opsec-bot/Reactivity/PROGRESS.md

# PROGRESS

Running log of what's done and what's known. Newest entries on top.

## On-board Lua scripts ✅ (2026-09-24)

New **Scripts** tab: write Lua in the app, "Run on board" uploads it to the Pico, which runs
it on its **second core** (core 1) with the same API as Logitech G Hub scripts
(`OnEvent`, `MoveMouseRelative`, `PressMouseButton`, `IsMouseButtonPressed`, `Sleep`,
`OutputLogMessage`, ...), so G Hub scripts paste in. Extension: `SetMouseButtonBlocked(n, on)`
hides a physical button from the PC. "Save to board" stores it in flash and it autostarts at
boot, so it works with the app closed.

- Firmware: Lua 5.4.8 vendored in `firmware/pico_device/src/lua/` (no io/os/package/debug,
  32-bit numbers, C recursion capped at 64). `script_engine.cpp` owns the VM: 24 KB private
  stack, 96 KB heap cap, pico-sdk queues to/from core 0 (button edges in; actions and log
  out). Core 0's hot path only gains one queue push per button edge.
- Stop is immediate even for `while true do end` or a loop wrapped in `pcall` (count hook +
  Sleep checks). A stopped or crashed script always releases any button it held.
- **Flash layout changed**: FQBN is now `flash=2097152_65536` (64 KB LittleFS for the
  script). The first boot after that formats the FS (~1 s). Saving briefly stalls
  passthrough (flash writes run with interrupts off).
- CDC: `script_begin/chunk/end` (base64, 150 B per line), `script_run/stop/save/erase/status`;
  the board replies `script_status`, `script_log`, and the 1 Hz status gained `"script"`.

Verified on hardware (Pico on COM7, 14 checks over the serial protocol): print/format,
PROFILE_ACTIVATED, syntax/runtime errors reported, busy loop + pcall-wrapped loop + Sleep
loop all stop, PROFILE_DEACTIVATED runs, heap cap -> "not enough memory" (board survives),
200-deep nesting rejected (no stack crash), unsupported-API message, a script moved the real
cursor 100 px left, oversize upload rejected, save/erase. `cargo check`, `tsc`, `vite build`.
NOT yet verified: button-triggered events from the physical mouse (needs someone pressing
buttons), autostart after a power cycle, and the Scripts tab in the running Tauri window.

---

## Firmware tab in the Control app ✅ (2026-09-24)

New **Firmware** tab: detects the boards, "Build & flash all" or per board, per-step
progress (build / flash / verify with timings), live output, actionable failure hints, and
an automatic serial disconnect before / reconnect after. Backend: `src-tauri/src/flash.rs`
runs `scripts/flash.py --json` on a std thread and forwards each line as a `flash://event`
(one run at a time; `exit` is always the last event). `serial::disconnect_blocking` joins the
reader thread so the COM port is really closed before flashing (the old `disconnect` only
queued a message). Frontend: `useFlasher` hook (lives in `App`, so a run keeps updating
while you look at another tab) + `FirmwarePanel`.

Verified: `cargo test` (7 unit + 1 real round trip through Python/arduino-cli, run with
`--include-ignored`), `tsc` strict + `vite build`, and the real frontend in a browser against
a mock backend replaying the script's event format: ok run, failed step with hint, backend
cannot start Python, nothing plugged in, per-board `--only`, switching tabs mid-run, and
disconnect -> flash -> reconnect. NOT yet verified: a real flash triggered from the running
Tauri window (the app must be restarted to pick up the new code: `pnpm tauri dev`).

---

## Flash tool ✅ (2026-09-24)

`scripts/flash.py` detects which boards are plugged in (via `arduino-cli board list`
JSON: CP210x `10C4:EA60` = ESP32, `046D:C547`/`239A:CAFE`/`2E8A:*` serial or a UF2
drive = Pico), builds the matching sketch and flashes it; a Pico already running this
firmware is rebooted into its bootloader by the 1200-baud touch, then checked to
re-enumerate as `046D:C547`. Missing boards are skipped, ambiguous ones need `--esp-port`
/ `--pico-port`. `--json` emits events for a future GUI button. 15 offline tests in
`scripts/test_flash.py`.

Tried on the real setup: `--check`, `--json`, `--build-only`, and a full run that flashed
both boards (Pico via the running-firmware path, 9.7 s, verified back on COM7). Not tried:
Pico-in-BOOTSEL and unplugged-board paths (unit-tested only). Builds are ~20-30 s each
normally; they took minutes while a game was hogging the CPU.

---

## Phase 5 — Low-latency pipeline ✅ 1 kHz feed verified on hardware (2026-09-24)

Flashed to the real boards and measured (results at the bottom). End-to-end latency is
still unmeasured. Originals are kept next to the sketches as `*.ino.orig` (this folder
is not a git repo).

### What was wrong
- **ESP32 host was the bottleneck.** `EspUsbHost::task()` was called from `loop()`.
  It blocks 1 tick in `usb_host_lib_handle_events()` and 1 tick in
  `usb_host_client_handle_events()` on every pass (tick = 1 ms here), and re-submits
  the IN transfer only on a `millis()` timer (`(now-last) > interval`, i.e. every
  >= 2 ms). Net: the dongle was polled at a few hundred Hz, not 1 kHz, and each
  report waited up to a tick before its callback ran. (Matches the Phase 2 log:
  0 -> 554 frames in ~2 s.) The old "sub-2 ms by construction" estimate did not hold.
- **Pico dropped motion.** `handleFrame` sent only `if (usb_hid.ready())`, otherwise
  the report was discarded. The dongle's 1 ms clock and the USB frame clock drift, so
  the endpoint is regularly busy at the wrong moment. Injected `move`/`click` had the
  same drop, and an injected click clobbered held physical buttons (and vice versa).
- CDC writes (ack/status/error) were unguarded; `Adafruit_USBD_CDC::write()` spins while
  its FIFO is full, so a GUI that stops reading could stall passthrough. The watch
  stream also ran `snprintf` per frame on the hot path. UART RX FIFO was 32 bytes.

### What changed
- **ESP32:** dedicated `usbClientTask` (prio 20) blocks in
  `usb_host_client_handle_events()` and wakes on completion; `onReceive()` copies the
  report, **re-arms the transfer immediately**, then remaps + forwards. **Three URBs are
  kept queued** on EP 0x81 (`MOUSE_URB_DEPTH`): re-arming a single URB was not enough
  (see Measured). Only the mouse endpoint is armed. `usbLibTask` handles enumeration.
  `loop()` is cold path only. TX ring buffer so `Serial1.write()` doesn't wait for the wire.
- **Pico:** coalescing report queue (fold same-button reports, keep press/release edges
  ordered, never drop motion, chunk to int16/int8); physical|injected buttons merged;
  hot path (UART -> queue -> USB) has no formatting/CDC/LED work; guarded CDC writes;
  256-byte UART FIFO; drop instead of accumulating while the host is not mounted.
- **Status line** gained `rx_hz, tx_hz, lat_avg_us, lat_max_us, merged, q_hwm`
  (additive; the app ignores unknown keys). ESP heartbeat now prints frames/s.

### Measured (Pico status line, continuous mouse motion, Superlight @ 1 kHz)
| ESP32 build | UART frames/s into the Pico (`rx_hz`) |
|---|---|
| Phase 2/4 (`task()` in `loop()`) | not measured; log implies ~280/s ("0 -> 554 in ~2 s") |
| Phase 5, one URB re-armed in the callback | 466 - 517 |
| Phase 5, **three URBs queued** (current) | **941 - 997, mean 958** (15 samples) |

So the mouse was reporting at 1 kHz all along; the ceiling was on our side. (Re-arming
fast was not the fix; queueing several URBs was. The *why* — a poll slot going empty
during resubmit — is inferred, the numbers are measured.)

- `frames_bad = 0` across ~140k frames: the UART link is clean.
- Pico residency (UART frame in -> USB send): **13 us average**, typically 20-36 us max.
  One report arrived while the IN endpoint was busy and was folded into the next one
  (`merged`, 1033 us residency) — the old firmware would have dropped it.
- Injected `move` acked and sent as its own USB report; remap round trip PC -> Pico ->
  reverse UART -> ESP works (table `0 1 2 4 4`, restored to identity).
- Queue/inject logic also run unmodified on the host against a fake endpoint: motion
  conserved exactly (200k-frame soak, overflow, chunking), button edges stay ordered,
  injected clicks OR with physical buttons and release independently.

### Not verified yet
- **End-to-end latency** (dongle report in -> PC sees it). `lat_*_us` is Pico-only.
- Injected **click/scroll** on hardware (host-tested only), dongle unplug/replug
  (reconnect path), and a long soak.
- Arming only EP 0x81 worked on this dongle; if another receiver stays silent, that is
  the first thing to suspect.

---

## Phase 4 — Pico USB identity ✅ (2026-06-07)

The Pico now presents to the PC as a generic **"Logitech USB Receiver"
(046D:C547)** — the same identity the real Superlight dongle would show — instead
of the TinyUSB default `239A:CAFE`. (Generic Logitech ID, allowed per §11.3; no
cheat-device IDs.)

- `pico_device.ino` setup(): `TinyUSBDevice.setManufacturerDescriptor("Logitech")`,
  `setProductDescriptor("USB Receiver")`, `setID(0x046D, 0xC547)`, then
  `detach()/attach()` to force re-enumeration (arduino-pico inits USB before
  setup()). Verified: `board list` shows the CDC as **046D:C547**.
- The HID report descriptor is unchanged, so passthrough/remap behave identically.
- **COM renumbers on identity change** (new VID/PID = new device to Windows):
  the Pico's CDC moved COM14 -> **COM15**. The app's `is_pico` now matches both
  the old (239A:CAFE) and new (046D:C547) IDs, so auto-select still works.

### Remaining Phase 4 (optional polish)
- README usage section; tag a release (e.g. v0.1.0).
- (Stretch) keyboard-HID on the Pico to enable keystroke remaps (ctrl+c etc.).

---

## Phase 3b — Button remap (ESP32 intercept) + DTR fix (2026-06-07)

### DTR fix — the watch/status "doesn't work" bug
Symptom: app Connected + Control worked, but Status tiles + Watch stayed empty
(Console showed only outgoing `->` lines, zero incoming `<-`).
Root cause: **Adafruit TinyUSB CDC gates device->host writes on DTR**
(`tud_cdc_connected()`); `serialport-rs` leaves DTR low on open, so the Pico
silently dropped every status/evt/ack line. (pyserial asserts DTR by default —
why the earlier Python test worked.) Fix: `serial.rs` asserts
`write_data_terminal_ready(true)` (+ RTS) right after open.

### Remap (button -> button intercept)
- Flow: app -> Pico (CDC) -> Pico forwards §9 `type=0x02` JSON frame on its
  reverse UART (GP0 TX) -> ESP32 stores the rule and **rewrites the buttons
  bitfield at the source** in `onReceive` (`applyRemap`). Identity by default.
- Scope: button->button and "none" (disable). Keystroke actions (ctrl+c) need a
  keyboard HID on the Pico — deferred.
- **New wire required:** Pico **GP0** (pin 1, UART0 TX) -> ESP32 **GPIO48**.
  (GND already shared; GPIO48 is free on the v1.1 DevKitC — RGB LED is on GPIO38.)
- ESP firmware: reverse-UART frame parser (`rfeed`) + `handleEspCmd` +
  `g_remap[5]` table; compiles 23%, flashed to COM7.

---

## Phase 3a — Tauri control app + Pico CDC protocol ✅ WORKING (2026-06-07)

A **Tauri v2 desktop app** ("Superlight Control", React + Tailwind v4 + shadcn)
drives the Pico over its USB-CDC serial port with the §9 JSON-line protocol.
Built and verified; `remap` (the cross-board bit) is deferred to **Phase 3b**.

### Stack
- `rust-client/` — Tauri v2. Frontend Vite + React 19 + TS + Tailwind v4 +
  shadcn/ui (slate, dark). Backend Rust: blocking `serialport` on a dedicated
  `std::thread` (NO async/tokio in our code, §11.6) bridging CDC lines to Tauri
  events (`serial://line`, `serial://status`).
- Pico firmware gained a CDC command layer (dependency-free JSON parse).

### Protocol (PC <-> Pico, JSON lines)
- PC->Pico: `move{dx,dy}` `click{btn}` `scroll{wheel}` `status` `watch{on}`
  `remap{from,to}`.
- Pico->PC: `{"type":"ack","what":..}`, `{"type":"status",uptime_ms,esp_alive,
  frames_ok,frames_bad,watching}` (1 Hz heartbeat, replaced the old plaintext),
  `{"type":"evt","kind":"mouse",buttons,dx,dy,wheel}` while watching.

### Verified
- Tauri app compiles: frontend (`pnpm build`, 1873 modules) + backend
  (`cargo check`, serialport 4.9).
- Pico reflashed; bidirectional test passed: `status`/`move`/`click`/`watch`
  all ack, status streams at 1 Hz, `watching` flips true.
- **Hot-path safety:** the `watch` stream only writes when
  `Serial.availableForWrite()` has room for the whole line — it drops events
  rather than blocking passthrough (protects the latency budget).

### Phase 3 acceptance (HANDOFF §10)
- [x] `rust-client/` compiles cleanly
- [x] move / click / scroll commands → HID injected on the Pico
- [x] watch → live event stream
- [ ] `remap` configures a rule on the ESP32 — **Phase 3b** (needs reverse-UART
      Pico GP0→ESP IO48 wired + ESP-side handler; the app/firmware already send
      the §9 type=0x02 frame, the ESP just ignores it for now)

### Remaining
- Phase 3b: wire reverse UART, ESP32 remap handler + type=0x03 reply relay.
- Carry-over from Phase 2: all-5-buttons/scroll confirm + latency measurement.

---

## Phase 2 — End-to-end pass-through ✅ WORKING (2026-06-07)

**Moving the Superlight moves the PC cursor through the full chain**, confirmed
on hardware:

```
Superlight ~RF~ Lightspeed dongle --USB host--> DevKitC-1 --UART 1Mbaud--> Pico H --USB HID--> PC
```

### Host board pivot: OTG board → DevKitC-1
- Phase 1 reverse-engineering was done on the **ESP32-S3-USB-OTG** board (dongle
  plugs straight into its USB_HOST port). That board is now **retired**.
- Phase 2 needs a UART wire from the host to the Pico (GPIO47 → GP1). The OTG
  board's free pins (GPIO47/48) are **bare solder pads** — no way to attach a
  jumper without a soldering iron (not on hand). So the host moved to the
  **ESP32-S3-DevKitC-1-N32R16V**, which has pre-soldered headers.
- The dongle now reaches the DevKitC's **native USB host** (GPIO19/20) via a
  **USB-A female breakout** wired to the headers. See `docs/esp32-s3-n32r16v.md`.

### What's verified
- DevKitC boots cleanly with `FlashMode=opi` (WROOM-2 Octal flash) — boot log
  shows `Octal Flash Mode Enabled`. Full FQBN in `docs/esp32-s3-n32r16v.md`.
- **Stage A:** dongle enumerates on native USB host; `frames sent` climbs on
  motion (e.g. 0 → 554 in ~2 s). USB-over-jumpers is electrically fine, no drops.
- **Stage B:** UART link GPIO47→GP1 (+ shared GND). Pico reports
  **`frames ok=N bad=0`** — zero CRC errors across thousands of frames = clean
  link, good ground. Pico HID `usb=ready` (mounted on PC).
- **Cursor moves** when the Superlight moves. ✅

### Gotcha worth remembering
- Opening **COM7** (the DevKitC `UART` port) asserts DTR/RTS and **auto-resets
  the ESP32**, briefly halting the stream. Watch the **Pico (COM14)** during live
  runs — it doesn't reset the chain. (Same DTR auto-reset that makes flashing work.)

### Remaining for Phase 2 sign-off
- Confirm all **5 buttons + scroll** pass through (movement confirmed).
- **Measure added latency** (target ≤2 ms, ≤5 ms hard cap).

---

## Phase 1 — Dongle decode ✅ COMPLETE

### Done
- Project scaffold created; git initialized.
- Toolchain verified (`arduino-cli` 1.5.1, esp32 core 3.0.0, EspUsbHost 1.0.1,
  pyserial 3.5, Rust/cargo present).
- COM-port map identified (see `docs/notes.md`).
- Dumper firmware compiles + uploads from CLI (no IDE GUI).
- Dongle enumerates on USB_HOST; descriptors captured to
  `captures/dongle-descriptors.log`.
- 1592 mouse reports captured to `captures/dongle-reports.log` covering all 5
  buttons + X/Y + wheel.
- `scripts/decode_reports.py` parses the capture and prints decoded events;
  verified L/R/M/back/fwd + wheel±1 + signed dx/dy all correct.

### Findings — THIS dongle (Logitech Lightspeed receiver)
- **VID:PID = `046D:C547`** ("Logitech USB Receiver"). bcdDevice 0x0204, bus
  powered, bMaxPower 98 mA. (Note: C547 is one of the IDs the brief greenlit for
  Phase 4 cloning — handy.)
- **3 HID interfaces, all bInterval=1 (1000 Hz):**
  | IF | EP | Role | Report-desc len |
  |---|---|---|---|
  | 0 | 0x81 | Mouse | 83 B |
  | 1 | 0x82 | Keyboard + Consumer + System | 133 B |
  | 2 | 0x83 | Logitech HID++ vendor (FF00) | 54 B |
- **Mouse report = 13 bytes, NO report ID** (endpoint 0x81):

  | byte | field | type |
  |---|---|---|
  | 0 | buttons 1–8 (bit0=L, bit1=R, bit2=M, bit3=back, bit4=fwd) | u8 bitfield |
  | 1 | buttons 9–16 (unused on Superlight, always 0) | u8 |
  | 2–3 | dX | **int16 LE** |
  | 4–5 | dY | **int16 LE** |
  | 6 | wheel | int8 |
  | 7 | hwheel / AC Pan | int8 |
  | 8–12 | vendor padding | 5×u8 |

- **Quirks / gotchas:**
  - The keyboard interface (EP 0x82) streams idle reports `01 00 00 …` (17 B,
    report ID 1) even when nothing is pressed — these are NOT mouse data. Filter
    by endpoint (mouse = 0x81).
  - **Build flag:** use `USBMode=default` on the `esp32s3usbotg` FQBN, NOT
    `hwcdc`. `hwcdc` sets cdc_on_boot=1 → `Serial` lands on the native USB CDC,
    which we reroute to the host port (invisible). `default` → `Serial` = UART0 →
    CP210x → COM12. (HANDOFF §5 advice was for the generic Dev Module.)
  - **DebugLevel=info** is required for EspUsbHost to print descriptors
    (`_printPcapText` is `#if ARDUHAL_LOG_LEVEL >= INFO`). Per-report flooding is
    gated at VERBOSE, so `info` is the right level: descriptors yes, flood no.
  - 16-bit X/Y means high-speed flicks won't clip at ±127 — maps cleanly onto the
    §9 UART payload `{buttons, dx:i16, dy:i16, wheel:i8, hwheel:i8}`.

### Next (Phase 2)
- ESP32: parse EP 0x81 reports natively in `onReceive`, frame per §9, send over
  UART (GPIO45/46 plan) at 1 Mbaud.
- Pico: TinyUSB HID mouse; receive UART frames, replay to PC.
- Measure latency (target ≤2 ms added, ≤5 ms hard cap).
