opsec-bot/Reactivity/docs/Pi-Pico-H-DOCS.md

Accept optional cookies Reject optional cookies

[Raspberry Pi](https://www.raspberrypi.com/)

*   [For industry](https://www.raspberrypi.com/for-industry/)
*   [For home](https://www.raspberrypi.com/for-home/)

*   [Hardware](https://www.raspberrypi.com/products/)
*   [Software](https://www.raspberrypi.com/software/)
*   [Documentation](https://www.raspberrypi.com/documentation/)
*   [News](https://www.raspberrypi.com/news/)
*   [Forums](https://forums.raspberrypi.com/)
*   [Foundation](https://www.raspberrypi.org)
*   [Contact](https://www.raspberrypi.com/contact/)

[Documentation](/documentation)
-------------------------------

*   [](/documentation/computers/)
    
    Computers

*   [](/documentation/computers/getting-started.html)
    
    Getting started

*   [
    
    Hardware prerequisites
    
    ](/documentation/computers/getting-started.html#hardware-prerequisites)

*   [
    
    Networking
    
    ](/documentation/computers/getting-started.html#networking)

*   [
    
    Set up your Raspberry Pi
    
    ](/documentation/computers/getting-started.html#setup)

*   [
    
    Install an OS onto boot media
    
    ](/documentation/computers/getting-started.html#install)

*   [
    
    Configuration
    
    ](/documentation/computers/getting-started.html#configuration)

*   [
    
    Shutdown options
    
    ](/documentation/computers/getting-started.html#shutdown)

*   [
    
    Troubleshooting
    
    ](/documentation/computers/getting-started.html#troubleshooting)

*   [
    
    Next steps
    
    ](/documentation/computers/getting-started.html#next)

*   [](/documentation/computers/os.html)
    
    Raspberry Pi OS

*   [
    
    OS installation
    
    ](/documentation/computers/os.html#os-installation)

*   [
    
    Manage software and firmware updates
    
    ](/documentation/computers/os.html#manage-software-and-firmware-updates)

*   [
    
    Play audio and video
    
    ](/documentation/computers/os.html#play-audio-and-video)

*   [
    
    Utilities
    
    ](/documentation/computers/os.html#utilities)

*   [
    
    Accessibility options
    
    ](/documentation/computers/os.html#accessibility-options)

*   [
    
    Use Python on a Raspberry Pi
    
    ](/documentation/computers/os.html#use-python-on-a-raspberry-pi)

*   [
    
    Use GPIO from Python
    
    ](/documentation/computers/os.html#use-gpio-from-python)

*   [](/documentation/computers/configuration.html)
    
    Configuration

*   [
    
    Configuration methods
    
    ](/documentation/computers/configuration.html#config-methods)

*   [
    
    Audio and visual output
    
    ](/documentation/computers/configuration.html#audio-and-visual-output)

*   [
    
    Networking
    
    ](/documentation/computers/configuration.html#networking)

*   [
    
    Wireless connection
    
    ](/documentation/computers/configuration.html#wireless-connection)

*   [
    
    System and localisation
    
    ](/documentation/computers/configuration.html#system-and-localisation)

*   [
    
    User access and management
    
    ](/documentation/computers/configuration.html#users)

*   [
    
    Remote access
    
    ](/documentation/computers/configuration.html#remote)

*   [
    
    Hardware communication
    
    ](/documentation/computers/configuration.html#hardware-communication)

*   [
    
    Performance
    
    ](/documentation/computers/configuration.html#performance)

*   [
    
    LED behaviour
    
    ](/documentation/computers/configuration.html#led-behaviour)

*   [
    
    Boot behaviour
    
    ](/documentation/computers/configuration.html#boot-behaviour)

*   [
    
    Firmware
    
    ](/documentation/computers/configuration.html#firmware)

*   [
    
    External storage
    
    ](/documentation/computers/configuration.html#external-storage)

*   [
    
    Operational security
    
    ](/documentation/computers/configuration.html#operational-security)

*   [
    
    Further reference
    
    ](/documentation/computers/configuration.html#further-reference)

*   [](/documentation/computers/config_txt.html)
    
    `config.txt`

*   [
    
    What is `config.txt`?
    
    ](/documentation/computers/config_txt.html#what-is-config-txt)

*   [
    
    `autoboot.txt`
    
    ](/documentation/computers/config_txt.html#autoboot-txt)

*   [
    
    Common options
    
    ](/documentation/computers/config_txt.html#common-options)

*   [
    
    Onboard analogue audio (3.5 mm jack)
    
    ](/documentation/computers/config_txt.html#onboard-analogue-audio-3-5-mm-jack)

*   [
    
    HDMI audio
    
    ](/documentation/computers/config_txt.html#hdmi-audio)

*   [
    
    Boot Options
    
    ](/documentation/computers/config_txt.html#boot-options)

*   [
    
    GPIO control
    
    ](/documentation/computers/config_txt.html#gpio-control)

*   [
    
    Overclocking options
    
    ](/documentation/computers/config_txt.html#overclocking-options)

*   [
    
    Conditional filters
    
    ](/documentation/computers/config_txt.html#conditional-filters)

*   [
    
    Memory options
    
    ](/documentation/computers/config_txt.html#memory-options)

*   [
    
    Licence key and codec options
    
    ](/documentation/computers/config_txt.html#licence-key-and-codec-options)

*   [
    
    Video options
    
    ](/documentation/computers/config_txt.html#video-options)

*   [
    
    Camera settings
    
    ](/documentation/computers/config_txt.html#camera-settings)

*   [](/documentation/computers/linux_kernel.html)
    
    The Linux kernel

*   [
    
    Introduction
    
    ](/documentation/computers/linux_kernel.html#kernel)

*   [
    
    Update
    
    ](/documentation/computers/linux_kernel.html#update)

*   [
    
    Build the kernel
    
    ](/documentation/computers/linux_kernel.html#building)

*   [
    
    Configure the kernel
    
    ](/documentation/computers/linux_kernel.html#configure-the-kernel)

*   [
    
    Patch the kernel
    
    ](/documentation/computers/linux_kernel.html#patch-the-kernel)

*   [
    
    Kernel headers
    
    ](/documentation/computers/linux_kernel.html#kernel-headers)

*   [
    
    Contribute
    
    ](/documentation/computers/linux_kernel.html#contribute)

*   [](/documentation/computers/remote-access.html)
    
    Remote access

*   [
    
    Introduction to remote access
    
    ](/documentation/computers/remote-access.html#introduction-to-remote-access)

*   [
    
    Find the IP address of your Raspberry Pi
    
    ](/documentation/computers/remote-access.html#ip-address)

*   [
    
    Access a remote terminal with SSH
    
    ](/documentation/computers/remote-access.html#ssh)

*   [
    
    Screen share with VNC
    
    ](/documentation/computers/remote-access.html#vnc)

*   [
    
    Remote access with Raspberry Pi Connect
    
    ](/documentation/computers/remote-access.html#raspberry-pi-connect)

*   [
    
    Share files with SCP
    
    ](/documentation/computers/remote-access.html#scp)

*   [
    
    Synchronise folders between computers with `rsync`
    
    ](/documentation/computers/remote-access.html#rsync)

*   [
    
    Network File System (NFS)
    
    ](/documentation/computers/remote-access.html#nfs)

*   [
    
    Samba (SMB/CIFS)
    
    ](/documentation/computers/remote-access.html#samba)

*   [
    
    Set up an Apache web server
    
    ](/documentation/computers/remote-access.html#set-up-an-apache-web-server)

*   [
    
    Network boot your Raspberry Pi
    
    ](/documentation/computers/remote-access.html#network-boot-your-raspberry-pi)

*   [
    
    Network boot using IPv6
    
    ](/documentation/computers/remote-access.html#network-boot-using-ipv6)

*   [](/documentation/computers/camera_software.html)
    
    Camera software

*   [
    
    `rpicam-apps`
    
    ](/documentation/computers/camera_software.html#rpicam-apps)

*   [
    
    Stream video over a network with `rpicam-apps`
    
    ](/documentation/computers/camera_software.html#stream-video-over-a-network-with-rpicam-apps)

*   [
    
    `rpicam-apps` options reference
    
    ](/documentation/computers/camera_software.html#rpicam-apps-options-reference)

*   [
    
    Post-processing with `rpicam-apps`
    
    ](/documentation/computers/camera_software.html#post-processing-with-rpicam-apps)

*   [
    
    Advanced `rpicam-apps`
    
    ](/documentation/computers/camera_software.html#advanced-rpicam-apps)

*   [
    
    Use a USB webcam
    
    ](/documentation/computers/camera_software.html#use-a-usb-webcam)

*   [
    
    V4L2 drivers
    
    ](/documentation/computers/camera_software.html#v4l2-drivers)

*   [
    
    Unicam
    
    ](/documentation/computers/camera_software.html#unicam)

*   [
    
    Troubleshooting
    
    ](/documentation/computers/camera_software.html#troubleshooting-2)

*   [
    
    Getting help
    
    ](/documentation/computers/camera_software.html#getting-help)

*   [](/documentation/computers/ai.html)
    
    AI software

*   [
    
    Hardware prerequisites
    
    ](/documentation/computers/ai.html#hardware)

*   [
    
    Software prerequisites
    
    ](/documentation/computers/ai.html#software)

*   [
    
    Run vision AI models on Raspberry Pi 5
    
    ](/documentation/computers/ai.html#vision-ai)

*   [
    
    Run LLMs on Raspberry Pi 5 (AI HAT+ 2 only)
    
    ](/documentation/computers/ai.html#LLMs)

*   [](/documentation/computers/raspberry-pi.html)
    
    Raspberry Pi computer hardware

*   [
    
    Introduction
    
    ](/documentation/computers/raspberry-pi.html#introduction)

*   [
    
    Schematics and mechanical drawings
    
    ](/documentation/computers/raspberry-pi.html#schematics-and-mechanical-drawings)

*   [
    
    Product compliance and safety
    
    ](/documentation/computers/raspberry-pi.html#product-compliance-and-safety)

*   [
    
    Frequency management and thermal control
    
    ](/documentation/computers/raspberry-pi.html#frequency-management-and-thermal-control)

*   [
    
    Raspberry Pi boot EEPROM
    
    ](/documentation/computers/raspberry-pi.html#raspberry-pi-boot-eeprom)

*   [
    
    Boot diagnostics
    
    ](/documentation/computers/raspberry-pi.html#boot-diagnostics)

*   [
    
    Raspberry Pi boot modes
    
    ](/documentation/computers/raspberry-pi.html#raspberry-pi-boot-modes)

*   [
    
    USB boot modes
    
    ](/documentation/computers/raspberry-pi.html#usb-boot-modes)

*   [
    
    USB mass storage boot
    
    ](/documentation/computers/raspberry-pi.html#usb-mass-storage-boot)

*   [
    
    Network booting
    
    ](/documentation/computers/raspberry-pi.html#network-booting)

*   [
    
    GPIO boot mode
    
    ](/documentation/computers/raspberry-pi.html#gpio-boot-mode)

*   [
    
    NVMe SSD boot
    
    ](/documentation/computers/raspberry-pi.html#nvme-ssd-boot)

*   [
    
    HTTP boot
    
    ](/documentation/computers/raspberry-pi.html#http-boot)

*   [
    
    Boot sequence
    
    ](/documentation/computers/raspberry-pi.html#boot-sequence)

*   [
    
    EEPROM boot flow
    
    ](/documentation/computers/raspberry-pi.html#eeprom-boot-flow)

*   [
    
    Raspberry Pi bootloader configuration
    
    ](/documentation/computers/raspberry-pi.html#raspberry-pi-bootloader-configuration)

*   [
    
    Display Parallel Interface (DPI)
    
    ](/documentation/computers/raspberry-pi.html#display-parallel-interface-dpi)

*   [
    
    GPIO and the 40-pin header
    
    ](/documentation/computers/raspberry-pi.html#gpio)

*   [
    
    GPIO pads control
    
    ](/documentation/computers/raspberry-pi.html#gpio-pads-control)

*   [
    
    Industrial use of the Raspberry Pi
    
    ](/documentation/computers/raspberry-pi.html#industrial-use-of-the-raspberry-pi)

*   [
    
    OTP register and bit definitions
    
    ](/documentation/computers/raspberry-pi.html#otp-register-and-bit-definitions)

*   [
    
    Raspberry Pi connector for PCIe
    
    ](/documentation/computers/raspberry-pi.html#raspberry-pi-connector-for-pcie)

*   [
    
    Power button
    
    ](/documentation/computers/raspberry-pi.html#power-button)

*   [
    
    Power supply
    
    ](/documentation/computers/raspberry-pi.html#power-supply)

*   [
    
    Real Time Clock (RTC)
    
    ](/documentation/computers/raspberry-pi.html#real-time-clock-rtc)

*   [
    
    Serial peripheral interface (SPI)
    
    ](/documentation/computers/raspberry-pi.html#spi-overview)

*   [
    
    Universal Serial Bus (USB)
    
    ](/documentation/computers/raspberry-pi.html#universal-serial-bus-usb)

*   [
    
    Raspberry Pi revision codes
    
    ](/documentation/computers/raspberry-pi.html#raspberry-pi-revision-codes)

*   [](/documentation/computers/keyboard-computers.html)
    
    Keyboard computers

*   [
    
    Features
    
    ](/documentation/computers/keyboard-computers.html#features)

*   [
    
    Keyboard computer kits
    
    ](/documentation/computers/keyboard-computers.html#keyboard-computer-kits)

*   [
    
    Getting started
    
    ](/documentation/computers/keyboard-computers.html#getting-started)

*   [
    
    Raspberry Pi 500+ mechanical keys
    
    ](/documentation/computers/keyboard-computers.html#mechanical-keys)

*   [
    
    Raspberry Pi 500+ customisation
    
    ](/documentation/computers/keyboard-computers.html#raspberry-pi-500-customisation)

*   [
    
    Advanced software settings
    
    ](/documentation/computers/keyboard-computers.html#advanced)

*   [](/documentation/computers/compute-module.html)
    
    Compute Module hardware

*   [
    
    Compute Modules
    
    ](/documentation/computers/compute-module.html#compute-modules)

*   [
    
    IO Boards
    
    ](/documentation/computers/compute-module.html#io-boards)

*   [
    
    CM5 and CM5IO accessories
    
    ](/documentation/computers/compute-module.html#cm5-and-cm5io-accessories)

*   [
    
    Flash an image to a Compute Module
    
    ](/documentation/computers/compute-module.html#flash-compute-module-emmc)

*   [
    
    Compute Module EEPROM bootloader
    
    ](/documentation/computers/compute-module.html#compute-module-eeprom-bootloader)

*   [
    
    Wire peripherals
    
    ](/documentation/computers/compute-module.html#wire-peripherals)

*   [
    
    Attach a Camera Module
    
    ](/documentation/computers/compute-module.html#attach-a-camera-module)

*   [
    
    Attach a Touch Display LCD panel
    
    ](/documentation/computers/compute-module.html#attach-a-touch-display-lcd-panel)

*   [
    
    Specifications
    
    ](/documentation/computers/compute-module.html#specifications)

*   [](/documentation/computers/processors.html)
    
    Processors

*   [
    
    BCM2835
    
    ](/documentation/computers/processors.html#bcm2835)

*   [
    
    BCM2836
    
    ](/documentation/computers/processors.html#bcm2836)

*   [
    
    BCM2837
    
    ](/documentation/computers/processors.html#bcm2837)

*   [
    
    BCM2837B0
    
    ](/documentation/computers/processors.html#bcm2837b0)

*   [
    
    BCM2711
    
    ](/documentation/computers/processors.html#bcm2711)

*   [
    
    BCM2712
    
    ](/documentation/computers/processors.html#bcm2712)

*   [
    
    RP3A0
    
    ](/documentation/computers/processors.html#rp3a0)

*   [](/documentation/computers/io-controllers.html)
    
    I/O controllers

*   [
    
    RP1 overview
    
    ](/documentation/computers/io-controllers.html#rp1-overview)

*   [
    
    Peripheral interfaces
    
    ](/documentation/computers/io-controllers.html#interfaces)

*   [
    
    Internal features
    
    ](/documentation/computers/io-controllers.html#features)

*   [
    
    Multimedia and audio components
    
    ](/documentation/computers/io-controllers.html#multimedia)

*   [
    
    RP1 naming
    
    ](/documentation/computers/io-controllers.html#rp1-naming)

*   [](/documentation/computers/software-sources.html)
    
    Software sources

*   [
    
    Finding software sources in Raspberry Pi OS
    
    ](/documentation/computers/software-sources.html#finding-software-sources-in-raspberry-pi-os)

*   [
    
    Our GitHub organisations
    
    ](/documentation/computers/software-sources.html#our-github-organisations)

*   [
    
    List of categorised sources
    
    ](/documentation/computers/software-sources.html#list-of-categorised-sources)

*   [](/documentation/computers/legacy_config_txt.html)
    
    Legacy `config.txt` options

*   [
    
    Legacy options
    
    ](/documentation/computers/legacy_config_txt.html#legacy-options)

*   [
    
    Legacy boot options
    
    ](/documentation/computers/legacy_config_txt.html#legacy-boot-options)

*   [
    
    Legacy overclocking options
    
    ](/documentation/computers/legacy_config_txt.html#legacy-overclocking-options)

*   [
    
    Legacy conditional filters
    
    ](/documentation/computers/legacy_config_txt.html#legacy-conditional-filters)

*   [
    
    Legacy memory options
    
    ](/documentation/computers/legacy_config_txt.html#legacy-memory-options)

*   [
    
    Legacy video options
    
    ](/documentation/computers/legacy_config_txt.html#legacy-video-options)

*   [
    
    Raspberry Pi 4 HDMI pipeline
    
    ](/documentation/computers/legacy_config_txt.html#raspberry-pi-4-hdmi-pipeline)

*   [
    
    Legacy Miscellaneous Options
    
    ](/documentation/computers/legacy_config_txt.html#legacy-miscellaneous-options)

*   [](/documentation/accessories/)
    
    Accessories

*   [](/documentation/accessories/sd-cards.html)
    
    SD Cards

*   [
    
    About
    
    ](/documentation/accessories/sd-cards.html#about)

*   [
    
    Specifications
    
    ](/documentation/accessories/sd-cards.html#specifications)

*   [](/documentation/accessories/ssds.html)
    
    SSDs

*   [
    
    About
    
    ](/documentation/accessories/ssds.html#about)

*   [
    
    Specifications
    
    ](/documentation/accessories/ssds.html#specifications)

*   [](/documentation/accessories/ssd-kit.html)
    
    SSD Kit

*   [
    
    About
    
    ](/documentation/accessories/ssd-kit.html#about)

*   [
    
    Install
    
    ](/documentation/accessories/ssd-kit.html#install)

*   [](/documentation/accessories/m2-hat-plus.html)
    
    M.2 HAT+

*   [
    
    About
    
    ](/documentation/accessories/m2-hat-plus.html#m2-hat-plus)

*   [
    
    Features
    
    ](/documentation/accessories/m2-hat-plus.html#features)

*   [
    
    Prepare your Raspberry Pi
    
    ](/documentation/accessories/m2-hat-plus.html#m2-hat-plus-installation)

*   [
    
    Install the M.2 HAT+
    
    ](/documentation/accessories/m2-hat-plus.html#standard-installation)

*   [
    
    Install the M.2 HAT+ Compact
    
    ](/documentation/accessories/m2-hat-plus.html#compact-installation)

*   [
    
    Start your Raspberry Pi
    
    ](/documentation/accessories/m2-hat-plus.html#start-your-raspberry-pi)

*   [
    
    Boot from NVMe
    
    ](/documentation/accessories/m2-hat-plus.html#boot-from-nvme)

*   [
    
    Enable PCIe Gen 3
    
    ](/documentation/accessories/m2-hat-plus.html#enable-pcie-gen-3)

*   [
    
    Schematics
    
    ](/documentation/accessories/m2-hat-plus.html#schematics)

*   [
    
    Product brief
    
    ](/documentation/accessories/m2-hat-plus.html#product-brief)

*   [](/documentation/accessories/display.html)
    
    Touch Display

*   [
    
    Raspberry Pi Touch Display
    
    ](/documentation/accessories/display.html#raspberry-pi-touch-display)

*   [
    
    Compatibility
    
    ](/documentation/accessories/display.html#compatibility)

*   [
    
    Autodetection
    
    ](/documentation/accessories/display.html#autodetection)

*   [
    
    Specifications
    
    ](/documentation/accessories/display.html#specifications)

*   [
    
    Mount a Raspberry Pi to the Touch Display
    
    ](/documentation/accessories/display.html#mount-a-raspberry-pi-to-the-touch-display)

*   [
    
    Connect to a Raspberry Pi B+ and later
    
    ](/documentation/accessories/display.html#connect-to-a-raspberry-pi-b-and-later)

*   [
    
    Connect to a Raspberry Pi 1 and earlier
    
    ](/documentation/accessories/display.html#connect-to-a-raspberry-pi-1-and-earlier)

*   [
    
    Connect to a Raspberry Pi Compute Module.
    
    ](/documentation/accessories/display.html#connect-to-cm)

*   [
    
    Disable touchscreen
    
    ](/documentation/accessories/display.html#disable-touchscreen)

*   [
    
    Disable display
    
    ](/documentation/accessories/display.html#disable-display)

*   [
    
    Use an on-screen keyboard
    
    ](/documentation/accessories/display.html#use-an-on-screen-keyboard)

*   [
    
    Change screen orientation
    
    ](/documentation/accessories/display.html#change-screen-orientation)

*   [
    
    Rotate touch input
    
    ](/documentation/accessories/display.html#rotate-touch-input)

*   [
    
    Touch Display device tree option reference
    
    ](/documentation/accessories/display.html#touch-display-device-tree-option-reference)

*   [](/documentation/accessories/touch-display-2.html)
    
    Touch Display 2

*   [
    
    Raspberry Pi Touch Display 2
    
    ](/documentation/accessories/touch-display-2.html#raspberry-pi-touch-display-2)

*   [
    
    Compatibility
    
    ](/documentation/accessories/touch-display-2.html#compatibility)

*   [
    
    Autodetection
    
    ](/documentation/accessories/touch-display-2.html#autodetection)

*   [
    
    Specifications
    
    ](/documentation/accessories/touch-display-2.html#specifications)

*   [
    
    Connect to a Raspberry Pi device
    
    ](/documentation/accessories/touch-display-2.html#connect-to-a-raspberry-pi-device)

*   [
    
    Troubleshooting
    
    ](/documentation/accessories/touch-display-2.html#troubleshooting)

*   [
    
    On-screen keyboard
    
    ](/documentation/accessories/touch-display-2.html#on-screen-keyboard)

*   [
    
    Change display orientation
    
    ](/documentation/accessories/touch-display-2.html#change-display-orientation)

*   [
    
    Change display brightness
    
    ](/documentation/accessories/touch-display-2.html#change-display-brightness)

*   [
    
    Customise touchscreen settings
    
    ](/documentation/accessories/touch-display-2.html#customise-touchscreen-settings)

*   [](/documentation/accessories/monitor.html)
    
    Monitor

*   [
    
    Raspberry Pi Monitor
    
    ](/documentation/accessories/monitor.html#raspberry-pi-monitor)

*   [](/documentation/accessories/camera.html)
    
    Camera

*   [
    
    About the Camera Modules
    
    ](/documentation/accessories/camera.html#about-the-camera-modules)

*   [
    
    Install a Raspberry Pi camera
    
    ](/documentation/accessories/camera.html#install-a-raspberry-pi-camera)

*   [
    
    Camera Module 2
    
    ](/documentation/accessories/camera.html#camera-module-2)

*   [
    
    Camera Module 3
    
    ](/documentation/accessories/camera.html#camera-module-3)

*   [
    
    Global Shutter Camera
    
    ](/documentation/accessories/camera.html#gs-camera)

*   [
    
    High Quality Camera
    
    ](/documentation/accessories/camera.html#hq-camera)

*   [
    
    Recommended Lenses
    
    ](/documentation/accessories/camera.html#lenses)

*   [
    
    Synchronous Captures
    
    ](/documentation/accessories/camera.html#synchronous-captures)

*   [
    
    External Trigger on the Global Shutter Camera
    
    ](/documentation/accessories/camera.html#external-trigger)

*   [
    
    IR Filter
    
    ](/documentation/accessories/camera.html#ir-filter)

*   [
    
    Hardware specifications
    
    ](/documentation/accessories/camera.html#hardware-specification)

*   [
    
    Advanced information
    
    ](/documentation/accessories/camera.html#advanced-information)

*   [](/documentation/accessories/ai-camera.html)
    
    AI Camera

*   [
    
    About
    
    ](/documentation/accessories/ai-camera.html#ai-camera)

*   [
    
    Getting started
    
    ](/documentation/accessories/ai-camera.html#getting-started)

*   [
    
    Run example applications
    
    ](/documentation/accessories/ai-camera.html#run-example-applications)

*   [
    
    Under the hood
    
    ](/documentation/accessories/ai-camera.html#under-the-hood)

*   [
    
    Model deployment
    
    ](/documentation/accessories/ai-camera.html#model-deployment)

*   [](/documentation/accessories/keyboard-and-mouse.html)
    
    Keyboard and mouse

*   [
    
    Getting Started with your Keyboard
    
    ](/documentation/accessories/keyboard-and-mouse.html#getting-started-with-your-keyboard)

*   [
    
    Getting Started with your Mouse
    
    ](/documentation/accessories/keyboard-and-mouse.html#getting-started-with-your-mouse)

*   [
    
    Connecting it all Together
    
    ](/documentation/accessories/keyboard-and-mouse.html#connecting-it-all-together)

*   [](/documentation/accessories/usb.html)
    
    USB accessories

*   [
    
    USB 3 Hub
    
    ](/documentation/accessories/usb.html#hub)

*   [
    
    Flash Drive
    
    ](/documentation/accessories/usb.html#flashdrive)

*   [](/documentation/accessories/build-hat.html)
    
    Build HAT

*   [
    
    About
    
    ](/documentation/accessories/build-hat.html#about-build-hat)

*   [
    
    Prepare your Build HAT
    
    ](/documentation/accessories/build-hat.html#prepare-your-build-hat)

*   [
    
    Use the Build HAT from Python
    
    ](/documentation/accessories/build-hat.html#use-the-build-hat-from-python)

*   [
    
    Use the Build HAT from .NET
    
    ](/documentation/accessories/build-hat.html#use-the-build-hat-from-net)

*   [
    
    Further Resources
    
    ](/documentation/accessories/build-hat.html#further-resources)

*   [
    
    Device Compatibility
    
    ](/documentation/accessories/build-hat.html#device-compatibility)

*   [
    
    Mechanical Drawings
    
    ](/documentation/accessories/build-hat.html#mechanical-drawings)

*   [](/documentation/accessories/sense-hat.html)
    
    Sense HAT

*   [
    
    About
    
    ](/documentation/accessories/sense-hat.html#about)

*   [
    
    Features
    
    ](/documentation/accessories/sense-hat.html#features)

*   [
    
    Install
    
    ](/documentation/accessories/sense-hat.html#install)

*   [
    
    Calibrate
    
    ](/documentation/accessories/sense-hat.html#calibrate)

*   [
    
    Getting started
    
    ](/documentation/accessories/sense-hat.html#getting-started)

*   [
    
    Troubleshooting
    
    ](/documentation/accessories/sense-hat.html#troubleshooting)

*   [](/documentation/accessories/ai-kit.html)
    
    AI Kit

*   [
    
    Hardware
    
    ](/documentation/accessories/ai-kit.html#hardware)

*   [
    
    Step 1. Mount an Active Cooler (recommended)
    
    ](/documentation/accessories/ai-kit.html#step1)

*   [
    
    Step 2. Mount the M.2 HAT+
    
    ](/documentation/accessories/ai-kit.html#step-2-mount-the-m-2-hat)

*   [
    
    Next steps: Run AI models
    
    ](/documentation/accessories/ai-kit.html#next-steps-run-ai-models)

*   [](/documentation/accessories/ai-hat-plus.html)
    
    AI HATs

*   [
    
    How it works
    
    ](/documentation/accessories/ai-hat-plus.html#explanation)

*   [
    
    Models
    
    ](/documentation/accessories/ai-hat-plus.html#AIHAT-models)

*   [
    
    Performance (TOPS) variants
    
    ](/documentation/accessories/ai-hat-plus.html#AIHAT-TOPS)

*   [
    
    Physical specifications
    
    ](/documentation/accessories/ai-hat-plus.html#physical-specifications)

*   [
    
    Hardware assembly
    
    ](/documentation/accessories/ai-hat-plus.html#ai-hat-plus-installation)

*   [
    
    Next steps: Run AI models
    
    ](/documentation/accessories/ai-hat-plus.html#next-steps-run-ai-models)

*   [](/documentation/accessories/audio.html)
    
    Raspberry Pi Audio

*   [
    
    Overview
    
    ](/documentation/accessories/audio.html#overview)

*   [
    
    Configuration
    
    ](/documentation/accessories/audio.html#configuration)

*   [
    
    Getting started
    
    ](/documentation/accessories/audio.html#getting-started)

*   [
    
    Hardware information
    
    ](/documentation/accessories/audio.html#hardware-information)

*   [
    
    Updating your firmware
    
    ](/documentation/accessories/audio.html#updating-your-firmware)

*   [](/documentation/accessories/tv-hat.html)
    
    TV HAT

*   [
    
    About
    
    ](/documentation/accessories/tv-hat.html#tv-hat)

*   [
    
    About DVB-T
    
    ](/documentation/accessories/tv-hat.html#about-dvb-t)

*   [
    
    Install
    
    ](/documentation/accessories/tv-hat.html#tv-hat-installation)

*   [
    
    Mechanical Drawing
    
    ](/documentation/accessories/tv-hat.html#mechanical-drawing)

*   [](/documentation/accessories/bumper.html)
    
    Bumper

*   [
    
    About
    
    ](/documentation/accessories/bumper.html#about)

*   [
    
    Assembly instructions
    
    ](/documentation/accessories/bumper.html#assembly-instructions)

*   [](/documentation/microcontrollers/)
    
    Microcontrollers

*   [](/documentation/microcontrollers/microcontroller-chips.html)
    
    Microcontroller chips

*   [
    
    Microcontroller overview
    
    ](/documentation/microcontrollers/microcontroller-chips.html#microcontroller-overview)

*   [
    
    RP2040
    
    ](/documentation/microcontrollers/microcontroller-chips.html#rp2040)

*   [
    
    RP2350
    
    ](/documentation/microcontrollers/microcontroller-chips.html#rp2350)

*   [
    
    USB identifiers
    
    ](/documentation/microcontrollers/microcontroller-chips.html#usb-identifiers)

*   [](/documentation/microcontrollers/radio-modules.html)
    
    Radio modules

*   [
    
    RM2 key features
    
    ](/documentation/microcontrollers/radio-modules.html#features)

*   [
    
    Technical specifications
    
    ](/documentation/microcontrollers/radio-modules.html#technical-specifications)

*   [
    
    Compliance
    
    ](/documentation/microcontrollers/radio-modules.html#compliance)

*   [](/documentation/microcontrollers/pico-series.html)
    
    Pico microcontroller boards

*   [
    
    Raspberry Pi Pico
    
    ](/documentation/microcontrollers/pico-series.html#pico1)

*   [
    
    Raspberry Pi Pico 2
    
    ](/documentation/microcontrollers/pico-series.html#pico2)

*   [
    
    Wireless models
    
    ](/documentation/microcontrollers/pico-series.html#wireless_models)

*   [
    
    Board layouts
    
    ](/documentation/microcontrollers/pico-series.html#layouts)

*   [
    
    Debug connector (SWD)
    
    ](/documentation/microcontrollers/pico-series.html#swd)

*   [
    
    Software utilities
    
    ](/documentation/microcontrollers/pico-series.html#software-utilities)

*   [](/documentation/microcontrollers/debug-probe.html)
    
    Raspberry Pi Debug Probe

*   [
    
    About the Debug Probe
    
    ](/documentation/microcontrollers/debug-probe.html#about-the-debug-probe)

*   [
    
    Getting started
    
    ](/documentation/microcontrollers/debug-probe.html#getting-started)

*   [
    
    Install tools
    
    ](/documentation/microcontrollers/debug-probe.html#install-tools)

*   [
    
    Starting a Debug Session
    
    ](/documentation/microcontrollers/debug-probe.html#starting-a-debug-session)

*   [
    
    Serial connections
    
    ](/documentation/microcontrollers/debug-probe.html#serial-connections)

*   [
    
    RTT connections
    
    ](/documentation/microcontrollers/debug-probe.html#rtt-connections)

*   [
    
    Updating the firmware on the Debug Probe
    
    ](/documentation/microcontrollers/debug-probe.html#updating-the-firmware-on-the-debug-probe)

*   [
    
    Schematics
    
    ](/documentation/microcontrollers/debug-probe.html#schematics)

*   [](/documentation/microcontrollers/micropython.html)
    
    MicroPython

*   [
    
    What is MicroPython?
    
    ](/documentation/microcontrollers/micropython.html#what-is-micropython)

*   [
    
    Drag-and-Drop MicroPython
    
    ](/documentation/microcontrollers/micropython.html#drag-and-drop-micropython)

*   [
    
    Where can I find documentation?
    
    ](/documentation/microcontrollers/micropython.html#where-can-i-find-documentation)

*   [
    
    Which hardware am I running on?
    
    ](/documentation/microcontrollers/micropython.html#which-hardware-am-i-running-on)

*   [](/documentation/microcontrollers/c_sdk.html)
    
    The C/C++ SDK

*   [
    
    SDK Setup
    
    ](/documentation/microcontrollers/c_sdk.html#sdk-setup)

*   [
    
    Raspberry Pi Pico C/C++ SDK
    
    ](/documentation/microcontrollers/c_sdk.html#raspberry-pi-pico-cc-sdk)

*   [
    
    Your First Binaries
    
    ](/documentation/microcontrollers/c_sdk.html#your-first-binaries)

*   [
    
    Quick-start your own project
    
    ](/documentation/microcontrollers/c_sdk.html#quick-start-your-own-project)

*   [](/documentation/services/)
    
    Services

*   [](/documentation/services/id.html)
    
    Raspberry Pi ID

*   [
    
    Create a Raspberry Pi ID
    
    ](/documentation/services/id.html#create-a-raspberry-pi-id)

*   [
    
    Enable Two-factor authentication
    
    ](/documentation/services/id.html#enable-two-factor-authentication)

*   [](/documentation/services/connect.html)
    
    Raspberry Pi Connect

*   [
    
    Introduction
    
    ](/documentation/services/connect.html#introduction)

*   [
    
    Manually start and stop Connect
    
    ](/documentation/services/connect.html#manually-start-and-stop-connect)

*   [
    
    Link a Raspberry Pi device with a Connect account
    
    ](/documentation/services/connect.html#link-connect)

*   [
    
    Access your Raspberry Pi device
    
    ](/documentation/services/connect.html#access-your-raspberry-pi-device)

*   [
    
    Enable remote shell at all times
    
    ](/documentation/services/connect.html#enable-remote-shell-at-all-times)

*   [
    
    Disable the animated icon
    
    ](/documentation/services/connect.html#disabling-the-animated-icon)

*   [
    
    Manage devices
    
    ](/documentation/services/connect.html#manage-devices)

*   [
    
    Update
    
    ](/documentation/services/connect.html#update)

*   [
    
    Disconnect a device from Connect
    
    ](/documentation/services/connect.html#disconnect-a-device-from-connect)

*   [
    
    Uninstall
    
    ](/documentation/services/connect.html#uninstall)

*   [
    
    Connect for Organisations
    
    ](/documentation/services/connect.html#connect-organisations)

*   [
    
    Troubleshooting
    
    ](/documentation/services/connect.html#troubleshooting)

*   [
    
    Security
    
    ](/documentation/services/connect.html#security)

*   [](/documentation/services/bookshelf.html)
    
    Bookshelf

*   [
    
    Introduction
    
    ](/documentation/services/bookshelf.html#bookshelf)

*   [
    
    Become a contributor (Raspberry Pi OS Trixie and later)
    
    ](/documentation/services/bookshelf.html#contribute)

*   [
    
    Download titles
    
    ](/documentation/services/bookshelf.html#download-titles)

*   [](/documentation/pico-sdk/)
    
    Pico C SDK

*   [](/documentation/pico-sdk/index_doxygen.html)
    
    Introduction

*   [
    
    Raspberry Pi Pico SDK
    
    ](/documentation/pico-sdk/index_doxygen.html#raspberry-pi-pico-sdk)

*   [](/documentation/pico-sdk/hardware.html)
    
    Hardware APIs

*   [
    
    hardware\_adc
    
    ](/documentation/pico-sdk/hardware.html#group_hardware_adc)

*   [
    
    hardware\_base
    
    ](/documentation/pico-sdk/hardware.html#group_hardware_base)

*   [
    
    hardware\_boot\_lock
    
    ](/documentation/pico-sdk/hardware.html#group_hardware_boot_lock)

*   [
    
    hardware\_claim
    
    ](/documentation/pico-sdk/hardware.html#group_hardware_claim)

*   [
    
    hardware\_clocks
    
    ](/documentation/pico-sdk/hardware.html#group_hardware_clocks)

*   [
    
    hardware\_divider
    
    ](/documentation/pico-sdk/hardware.html#group_hardware_divider)

*   [
    
    hardware\_dcp **RP2350**
    
    ](/documentation/pico-sdk/hardware.html#group_hardware_dcp)

*   [
    
    hardware\_dma
    
    ](/documentation/pico-sdk/hardware.html#group_hardware_dma)

*   [
    
    hardware\_exception
    
    ](/documentation/pico-sdk/hardware.html#group_hardware_exception)

*   [
    
    hardware\_flash
    
    ](/documentation/pico-sdk/hardware.html#group_hardware_flash)

*   [
    
    hardware\_gpio
    
    ](/documentation/pico-sdk/hardware.html#group_hardware_gpio)

*   [
    
    hardware\_hazard3 **RP2350**
    
    ](/documentation/pico-sdk/hardware.html#group_hardware_hazard3)

*   [
    
    hardware\_i2c
    
    ](/documentation/pico-sdk/hardware.html#group_hardware_i2c)

*   [
    
    hardware\_interp
    
    ](/documentation/pico-sdk/hardware.html#group_hardware_interp)

*   [
    
    hardware\_irq
    
    ](/documentation/pico-sdk/hardware.html#group_hardware_irq)

*   [
    
    hardware\_pio
    
    ](/documentation/pico-sdk/hardware.html#group_hardware_pio)

*   [
    
    hardware\_pll
    
    ](/documentation/pico-sdk/hardware.html#group_hardware_pll)

*   [
    
    hardware\_powman **RP2350**
    
    ](/documentation/pico-sdk/hardware.html#group_hardware_powman)

*   [
    
    hardware\_pwm
    
    ](/documentation/pico-sdk/hardware.html#group_hardware_pwm)

*   [
    
    hardware\_resets
    
    ](/documentation/pico-sdk/hardware.html#group_hardware_resets)

*   [
    
    hardware\_riscv **RP2350**
    
    ](/documentation/pico-sdk/hardware.html#group_hardware_riscv)

*   [
    
    hardware\_riscv\_platform\_timer **RP2350**
    
    ](/documentation/pico-sdk/hardware.html#group_hardware_riscv_platform_timer)

*   [
    
    hardware\_rtc **RP2040**
    
    ](/documentation/pico-sdk/hardware.html#group_hardware_rtc)

*   [
    
    hardware\_rcp **RP2350**
    
    ](/documentation/pico-sdk/hardware.html#group_hardware_rcp)

*   [
    
    hardware\_spi
    
    ](/documentation/pico-sdk/hardware.html#group_hardware_spi)

*   [
    
    hardware\_sha256 **RP2350**
    
    ](/documentation/pico-sdk/hardware.html#group_hardware_sha256)

*   [
    
    hardware\_sync
    
    ](/documentation/pico-sdk/hardware.html#group_hardware_sync)

*   [
    
    hardware\_ticks
    
    ](/documentation/pico-sdk/hardware.html#group_hardware_ticks)

*   [
    
    hardware\_timer
    
    ](/documentation/pico-sdk/hardware.html#group_hardware_timer)

*   [
    
    hardware\_uart
    
    ](/documentation/pico-sdk/hardware.html#group_hardware_uart)

*   [
    
    hardware\_vreg
    
    ](/documentation/pico-sdk/hardware.html#group_hardware_vreg)

*   [
    
    hardware\_watchdog
    
    ](/documentation/pico-sdk/hardware.html#group_hardware_watchdog)

*   [
    
    hardware\_xip\_cache
    
    ](/documentation/pico-sdk/hardware.html#group_hardware_xip_cache)

*   [
    
    hardware\_xosc
    
    ](/documentation/pico-sdk/hardware.html#group_hardware_xosc)

*   [](/documentation/pico-sdk/high_level.html)
    
    High Level APIs

*   [
    
    pico\_aon\_timer
    
    ](/documentation/pico-sdk/high_level.html#group_pico_aon_timer)

*   [
    
    pico\_async\_context
    
    ](/documentation/pico-sdk/high_level.html#group_pico_async_context)

*   [
    
    pico\_bootsel\_via\_double\_reset
    
    ](/documentation/pico-sdk/high_level.html#group_pico_bootsel_via_double_reset)

*   [
    
    pico\_fix
    
    ](/documentation/pico-sdk/high_level.html#group_pico_fix)

*   [
    
    pico\_flash
    
    ](/documentation/pico-sdk/high_level.html#group_pico_flash)

*   [
    
    pico\_i2c\_slave
    
    ](/documentation/pico-sdk/high_level.html#group_pico_i2c_slave)

*   [
    
    pico\_multicore
    
    ](/documentation/pico-sdk/high_level.html#group_pico_multicore)

*   [
    
    pico\_rand
    
    ](/documentation/pico-sdk/high_level.html#group_pico_rand)

*   [
    
    pico\_sha256 **RP2350**
    
    ](/documentation/pico-sdk/high_level.html#group_pico_sha256)

*   [
    
    pico\_status\_led
    
    ](/documentation/pico-sdk/high_level.html#group_pico_status_led)

*   [
    
    pico\_stdlib
    
    ](/documentation/pico-sdk/high_level.html#group_pico_stdlib)

*   [
    
    pico\_sync
    
    ](/documentation/pico-sdk/high_level.html#group_pico_sync)

*   [
    
    pico\_time
    
    ](/documentation/pico-sdk/high_level.html#group_pico_time)

*   [
    
    pico\_unique\_id
    
    ](/documentation/pico-sdk/high_level.html#group_pico_unique_id)

*   [
    
    pico\_util
    
    ](/documentation/pico-sdk/high_level.html#group_pico_util)

*   [](/documentation/pico-sdk/third_party.html)
    
    Third-party Libraries

*   [
    
    tinyusb\_device
    
    ](/documentation/pico-sdk/third_party.html#group_tinyusb_device)

*   [
    
    tinyusb\_host
    
    ](/documentation/pico-sdk/third_party.html#group_tinyusb_host)

*   [
    
    pico\_mbedtls
    
    ](/documentation/pico-sdk/third_party.html#group_pico_mbedtls)

*   [](/documentation/pico-sdk/networking.html)
    
    Networking Libraries

*   [
    
    pico\_btstack
    
    ](/documentation/pico-sdk/networking.html#group_pico_btstack)

*   [
    
    pico\_lwip
    
    ](/documentation/pico-sdk/networking.html#group_pico_lwip)

*   [
    
    pico\_cyw43\_driver
    
    ](/documentation/pico-sdk/networking.html#group_pico_cyw43_driver)

*   [
    
    pico\_cyw43\_arch
    
    ](/documentation/pico-sdk/networking.html#group_pico_cyw43_arch)

*   [](/documentation/pico-sdk/runtime.html)
    
    Runtime Infrastructure

*   [
    
    boot\_stage2
    
    ](/documentation/pico-sdk/runtime.html#group_boot_stage2)

*   [
    
    pico\_atomic
    
    ](/documentation/pico-sdk/runtime.html#group_pico_atomic)

*   [
    
    pico\_base
    
    ](/documentation/pico-sdk/runtime.html#group_pico_base)

*   [
    
    pico\_binary\_info
    
    ](/documentation/pico-sdk/runtime.html#group_pico_binary_info)

*   [
    
    pico\_bootrom
    
    ](/documentation/pico-sdk/runtime.html#group_pico_bootrom)

*   [
    
    pico\_bit\_ops
    
    ](/documentation/pico-sdk/runtime.html#group_pico_bit_ops)

*   [
    
    pico\_cxx\_options
    
    ](/documentation/pico-sdk/runtime.html#group_pico_cxx_options)

*   [
    
    pico\_clib\_interface
    
    ](/documentation/pico-sdk/runtime.html#group_pico_clib_interface)

*   [
    
    pico\_crt0
    
    ](/documentation/pico-sdk/runtime.html#group_pico_crt0)

*   [
    
    pico\_divider
    
    ](/documentation/pico-sdk/runtime.html#group_pico_divider)

*   [
    
    pico\_double
    
    ](/documentation/pico-sdk/runtime.html#group_pico_double)

*   [
    
    pico\_float
    
    ](/documentation/pico-sdk/runtime.html#group_pico_float)

*   [
    
    pico\_int64\_ops
    
    ](/documentation/pico-sdk/runtime.html#group_pico_int64_ops)

*   [
    
    pico\_malloc
    
    ](/documentation/pico-sdk/runtime.html#group_pico_malloc)

*   [
    
    pico\_mem\_ops
    
    ](/documentation/pico-sdk/runtime.html#group_pico_mem_ops)

*   [
    
    pico\_platform
    
    ](/documentation/pico-sdk/runtime.html#group_pico_platform)

*   [
    
    pico\_printf
    
    ](/documentation/pico-sdk/runtime.html#group_pico_printf)

*   [
    
    pico\_runtime
    
    ](/documentation/pico-sdk/runtime.html#group_pico_runtime)

*   [
    
    pico\_runtime\_init
    
    ](/documentation/pico-sdk/runtime.html#group_pico_runtime_init)

*   [
    
    pico\_stdio
    
    ](/documentation/pico-sdk/runtime.html#group_pico_stdio)

*   [
    
    pico\_standard\_binary\_info
    
    ](/documentation/pico-sdk/runtime.html#group_pico_standard_binary_info)

*   [
    
    pico\_standard\_link
    
    ](/documentation/pico-sdk/runtime.html#group_pico_standard_link)

*   [](/documentation/pico-sdk/misc.html)
    
    External API Headers

*   [
    
    boot\_picobin\_headers
    
    ](/documentation/pico-sdk/misc.html#group_boot_picobin_headers)

*   [
    
    boot\_picoboot\_headers
    
    ](/documentation/pico-sdk/misc.html#group_boot_picoboot_headers)

*   [
    
    boot\_uf2\_headers
    
    ](/documentation/pico-sdk/misc.html#group_boot_uf2_headers)

*   [
    
    pico\_usb\_reset\_interface\_headers
    
    ](/documentation/pico-sdk/misc.html#group_pico_usb_reset_interface_headers)

*   [
    
    Product Information Portal
    
    ](https://pip.raspberrypi.com/ "Raspberry Pi compliance documents")

*   [
    
    Tutorials
    
    ](https://www.raspberrypi.com/tutorials/ "Hands-on hardware and software tutorials")

*   [
    
    Forums
    
    ](https://forums.raspberrypi.com "User and product support forums")

Pico microcontroller boards
===========================

Raspberry Pi Pico is a development board that uses Raspberry Pi [microcontrollers](../microcontrollers/microcontroller-chips.html) (**RP2040** or **RP2350**). A Raspberry Pi Pico is programmed using **MicroPython**, **C**, or **C++** and, unlike other Raspberry Pi devices, doesn’t run Linux or support removable storage. Instead, Raspberry Pi Pico is programmed by flashing binaries to the on-board flash memory.

There are two generations of the Raspberry Pi Pico series:

*   [Raspberry Pi Pico](#pico1) (Pico 1)
    
*   [Raspberry Pi Pico 2](#pico2)

Each generation is available in four variants, which differ based on:

*   **Wireless connectivity.** Variants that include the **W** suffix in the name include Wi-Fi and Bluetooth.
    
*   **Presoldered headers.** Variants are available either as castellated modules (for direct soldering) or with presoldered pin headers.

[](#pico1)Raspberry Pi Pico
---------------------------

Edit this [on GitHub](https://github.com/raspberrypi/documentation/blob/master/documentation/asciidoc/microcontrollers/pico-series/about_pico.adoc)

The first generation of Raspberry Pi Pico is based on the [RP2040](../microcontrollers/microcontroller-chips.html#rp2040) microcontroller chip. It comes in four variants, listed in [Table 1](#pico1-variants). For more detail about the variants, see [Non-wireless Raspberry Pi Pico boards](#non-wireless_pico) (Raspberry Pi **Pico** and **Pico H**) and [Wireless Raspberry Pi Pico boards](#wireless_pico) (Raspberry Pi **Pico W** and Pico **WH**).

Raspberry Pi Pico variants   

Wireless

Headers

Raspberry Pi **Pico**

No

No

Raspberry Pi **Pico H**

No

Yes (presoldered)

Raspberry Pi **Pico W**

Yes (Wi-Fi and Bluetooth)

No

Raspberry Pi **Pico WH**

Yes (Wi-Fi and Bluetooth)

Yes (presoldered)

[Figure 1](#pico1-image) provides a visual reference for the four Raspberry Pi Pico variants as seen from the top. Visually, these variants differ most obviously based on:

*   The presence or absence of a wireless component.
    
*   The presence or absence of presoldered header pins.
    
*   The location and type of Serial Wire Debug (SWD) interface.

For more information about these differences, see [Non-wireless Raspberry Pi Pico boards](#non-wireless_pico) and [Wireless Raspberry Pi Pico boards](#wireless_pico).

pico 1s

The four Raspberry Pi Pico variants; from left to right: Raspberry Pi **Pico**, Raspberry Pi **Pico H**, Raspberry Pi **Pico W**, and Raspberry Pi **Pico WH**

### [](#non-wireless_pico)Non-wireless Raspberry Pi Pico boards

Raspberry Pi **Pico** and **Pico H** are first-generation, non-wireless microcontroller boards based on the RP2040 chip. Both boards offer identical hardware capabilities, with the only physical differences being the presence of presoldered header pins on Raspberry Pi Pico H, and the style of the debug connector at the bottom of the boards. For more information, see [Debug connector (SWD)](#swd).

The pinout and board layout for Raspberry Pi Pico and Pico H is the same as for Raspberry Pi **Pico 2** and **Pico 2 with headers**. For more information, see [Non-wireless board layout](#layout_non-wireless).

#### [](#key-features)Key features

Raspberry Pi **Pico** and **Pico H** offer the following key features:

*   **RP2040 microcontroller chip**, including:
    
    *   Dual-core M0+ processor.
        
    *   Flexible clock running up to 133 MHz.
        
    *   264 kB of SRAM.
        
    *   USB 1.1 controller and PHY with device and host support.
        
    *   Low-power sleep and dormant modes.
        
    *   Accurate clock and timer.
        
    *   Accelerated floating-point libraries.
        
    *   Temperature sensor.
        
    *   Eight Programmable I/O (PIO) state machines for custom peripheral support.
        
        *   Flexible, user-programmable high-speed I/O.
            
        *   Can emulate interfaces such as SD card and VGA.

*   **Board features**:
    
    *   Drag-and-drop programming using mass storage over USB.
        
    *   2 MB of on-board flash memory.
        
    *   26 multi-function GPIO pins. For more information, see [Non-wireless board layout](#layout_non-wireless).
        
    *   Debug connector. For more information, see [Debug connector (SWD)](#swd).

*   **Peripheral interfaces**:
    
    *   Two SPI
        
    *   Two I2C
        
    *   Two UART
        
    *   Three 12-bit ADC
        
    *   16 PWM channels

#### [](#resources-for-non-wireless-raspberry-pi-pico-boards)Resources for non-wireless Raspberry Pi Pico boards

Raspberry Pi offers additional technical documentation relevant to Raspberry Pi Pico and Pico H:

*   [RP2040 Datasheet: A microcontroller by Raspberry Pi](https://pip.raspberrypi.com/documents/RP-008371-DS)
    
*   [Raspberry Pi Pico Datasheet: An RP2040-based microcontroller board](https://pip.raspberrypi.com/documents/RP-008307-DS)
    
*   [Hardware design with RP2040: Using RP2040 microcontrollers to build boards and products](https://pip.raspberrypi.com/documents/RP-008279-DS)
    
*   [Getting started with Raspberry Pi Pico-series microcontrollers: C/C++ development with Raspberry Pi Pico-series and other Raspberry Pi microcontroller-based boards](https://pip.raspberrypi.com/documents/RP-008276-DS)

Additionally, Raspberry Pi provides the following supporting hardware design resources:

*   [Design files](https://pip.raspberrypi.com/documents/RP-008379-DS) (Cadence Allegro): PCB design files for studying or reproducing the board layout.
    
*   [STEP file](https://pip.raspberrypi.com/documents/RP-008311-DS): a 3-dimensional CAD model of the board for enclosure and mechanical design.
    
*   [Fritzing](https://fritzing.org) parts: components for use in Fritzing, an electronics design tool for layouts and schematics:
    
    *   [Fritzing part for Raspberry Pi Pico](https://pip.raspberrypi.com/documents/RP-008310-DS)
        
    *   [Fritzing part for Raspberry Pi Pico H](https://pip.raspberrypi.com/documents/RP-008314-DS)

Important

Design files for Raspberry Pi Pico and Pico H are openly available with no limitations. Raspberry Pi grants permission to use, copy, modify, and distribute the following designs for any purpose, with or without fee. Designs are provided 'as-is' and the author disclaims all warranties with regard to the design, including all implied warranties of merchantability and fitness. In no event shall the author be liable for any special, direct, indirect, or consequential damages or any damages whatsoever resulting from loss of use, data, or profits, whether in an action of contract, negligence, or other tortious action, arising out of or in connection with the use or performance of the design.

### [](#wireless_pico)Wireless Raspberry Pi Pico boards

Raspberry Pi **Pico W** and **Pico WH** are first-generation, wireless microcontroller boards based on the RP2040 chip. Both boards offer identical hardware capabilities, with the only physical differences being the presence of presoldered header pins on Raspberry Pi Pico WH, and the style of the debug connector below the microcontroller. For more information, see [Debug connector (SWD)](#swd).

The pinout and board layout for Raspberry Pi Pico W and Pico WH is the same as for Raspberry Pi **Pico 2 W** and **Pico 2 W with headers**. For more information, see [Wireless board layout](#layout_wireless).

#### [](#key-features-2)Key features

Raspberry Pi **Pico W** and **Pico WH** offer the same key features as Raspberry Pi **Pico** and **Pico H**, but with added wireless functionality. Specifically, Raspberry Pi Pico W and Pico WH offer the following key features:

*   **RP2040 microcontroller chip**, including:
    
    *   Dual-core M0+ processor.
        
    *   Flexible clock running up to 133 MHz.
        
    *   264 kB of SRAM.
        
    *   USB 1.1 controller and PHY with device and host support.
        
    *   Low-power sleep and dormant modes.
        
    *   Accurate clock and timer.
        
    *   Accelerated floating-point libraries.
        
    *   Temperature sensor.
        
    *   Eight Programmable I/O (PIO) state machines for custom peripheral support.
        
        *   Flexible, user-programmable high-speed I/O.
            
        *   Can emulate interfaces such as SD card and VGA.

*   **Board features**:
    
    *   Drag-and-drop programming using mass storage over USB.
        
    *   2 MB of on-board flash memory.
        
    *   26 multi-function GPIO pins. For more information, see [Wireless board layout](#layout_wireless).
        
    *   Debug connector. For more information, see [Debug connector (SWD)](#swd).

*   **Peripheral interfaces**:
    
    *   Two SPI
        
    *   Two I2C
        
    *   Two UART
        
    *   Three 12-bit ADC
        
    *   16 PWM channels

*   **Wireless connectivity**:
    
    *   Wi-Fi (802.11n):
        
        *   Single-band (2.4 GHz).
            
        *   WPA3, a modern security protocol for wireless connectivity.
            
        *   Soft access point for broadcasting a Wi-Fi network, supporting up to four clients.

    *   Bluetooth 5.2:
        
        *   Support for Bluetooth Low Energy (BLE) Central and Peripheral roles.
            
        *   Support for Bluetooth Classic.

For more information about the wireless hardware and functionality of Raspberry Pi Pico W and Pico WH, see [Wireless models](#wireless_models).

#### [](#resources-for-wireless-raspberry-pi-pico-boards)Resources for wireless Raspberry Pi Pico boards

Raspberry Pi offers additional technical documentation relevant to Raspberry Pi Pico W and Pico WH:

*   [RP2040 Datasheet: A microcontroller by Raspberry Pi](https://pip.raspberrypi.com/documents/RP-008371-DS)
    
*   [Raspberry Pi Pico W Datasheet: An RP2040-based microcontroller board](https://pip.raspberrypi.com/documents/RP-008312-DS)
    
*   [Hardware design with RP2040: Using RP2040 microcontrollers to build boards and products](https://pip.raspberrypi.com/documents/RP-008279-DS)
    
*   [Connecting to the Internet with Raspberry Pi Pico W-series: Getting online with C/C++ or MicroPython on W-series devices](https://pip.raspberrypi.com/documents/RP-008257-DS)

Additionally, Raspberry Pi provides the following supporting hardware design resources:

*   [Design files](https://pip.raspberrypi.com/documents/RP-008380-DS) (Cadence Allegro): PCB design files for studying or reproducing the board layout.
    
*   [STEP file](https://pip.raspberrypi.com/documents/RP-008318-DS): a 3-dimensional CAD model of the board for enclosure and mechanical design.
    
*   [Fritzing](https://fritzing.org) part: component for use in Fritzing, an electronics design tool for layouts and schematics: [Fritzing part for Raspberry Pi Pico W](https://pip.raspberrypi.com/documents/RP-008316-DS).

Important

Design files for Raspberry Pi Pico W and Pico WH are openly available with no limitations. Raspberry Pi grants permission to use, copy, modify, and distribute the following designs for any purpose, with or without fee. Designs are provided 'as-is' and the author disclaims all warranties with regard to the design, including all implied warranties of merchantability and fitness. In no event shall the author be liable for any special, direct, indirect, or consequential damages or any damages whatsoever resulting from loss of use, data, or profits, whether in an action of contract, negligence, or other tortious action, arising out of or in connection with the use or performance of the design.

[](#pico2)Raspberry Pi Pico 2
-----------------------------

Raspberry Pi Pico 2 is based on the [RP2350](../microcontrollers/microcontroller-chips.html#rp2350) microcontroller chip. It comes in four variants, listed in [Table 2](#pico2-variants). Unlike Raspberry Pi **Pico H** and **Pico WH**, 'headers' isn’t shortened to '**H**'.

Raspberry Pi Pico 2 variants   

Wireless

Headers

Raspberry Pi **Pico 2**

No

No

Raspberry Pi **Pico 2 with headers**

No

Yes (presoldered)

Raspberry Pi **Pico 2 W**

Yes (Wi-Fi and Bluetooth)

No

Raspberry Pi **Pico 2 W with headers**

Yes (Wi-Fi and Bluetooth)

Yes (presoldered)

[Figure 2](#pico2-image) provides a visual reference for the four Raspberry Pi Pico 2 variants as seen from the top. Visually, these variants differ most obviously based on:

*   The presence or absence of a wireless component.
    
*   The presence or absence of presoldered header pins.
    
*   The location and type of Serial Wire Debug (SWD) interface.

For more information about these differences, see [Non-wireless Raspberry Pi Pico 2 boards](#non-wireless_pico2) and [Wireless Raspberry Pi Pico 2 boards](#wireless_pico2).

pico 2s

The four Raspberry Pi Pico 2 variants; from left to right: Raspberry Pi **Pico 2**, Raspberry Pi **Pico 2 with headers**, Raspberry Pi **Pico 2 W**, and Raspberry Pi **Pico 2 W with headers**

### [](#non-wireless_pico2)Non-wireless Raspberry Pi Pico 2 boards

Raspberry Pi **Pico 2** and **Pico 2 with headers** are non-wireless microcontroller boards based on the RP2350 chip. Both boards offer identical hardware capabilities, with the only physical differences being the presence of presoldered header pins on Raspberry Pi **Pico 2 with headers**, and the style of the debug connector at the bottom of the boards. For more information, see [Debug connector (SWD)](#swd).

The pinout and board layout for Raspberry Pi **Pico 2** and **Pico 2 with headers** is the same as for Raspberry Pi **Pico** and **Pico H**. For more information, see [Non-wireless board layout](#layout_non-wireless).

#### [](#key-features-3)Key features

Raspberry Pi **Pico 2** and **Pico 2 with headers** offer the following key features:

*   **RP2350 microcontroller chip**, including:
    
    *   A choice of CPU architecture that can run tasks in parallel. For more information, see [Architecture switching](../microcontrollers/microcontroller-chips.html#architecture_switching):
        
        *   Dual-core Arm Cortex-M33.
            
        *   Dual-core Hazard3 RISC-V processor.

    *   Flexible clock running up to 150 MHz.
        
    *   520 kB of SRAM.
        
    *   USB 1.1 controller and PHY with device and host support.
        
    *   Low-power sleep and dormant modes.
        
    *   Accurate clock and timer.
        
    *   Temperature sensor.
        
    *   Twelve Programmable I/O (PIO) state machines for custom peripheral support.
        
        *   Flexible, user-programmable high-speed I/O.
            
        *   Can emulate interfaces such as SD card and VGA.

*   **Board features**:
    
    *   Drag-and-drop programming using mass storage over USB.
        
    *   4 MB of on-board flash memory.
        
    *   26 multi-function GPIO pins. For more information, see [Non-wireless board layout](#layout_non-wireless).
        
    *   Hardware and software compatibility with Raspberry Pi Pico 1.
        
    *   Two timers with 4 alarms, and an AON timer.
        
    *   Debug connector. For more information, see [Debug connector (SWD)](#swd).

*   **Peripheral interfaces**:
    
    *   Two SPI
        
    *   Two I2C
        
    *   Two UART
        
    *   Three 12-bit ADC
        
    *   16 PWM channels

#### [](#resources)Resources

Raspberry Pi offers additional technical documentation relevant to Raspberry Pi Pico 2 and Pico 2 with headers:

*   [RP2350 Datasheet: A microcontroller by Raspberry Pi](https://pip.raspberrypi.com/documents/RP-008373-DS)
    
*   [Raspberry Pi Pico 2 Datasheet: An RP2350-based microcontroller board](https://pip.raspberrypi.com/documents/RP-008299-DS)
    
*   [Hardware design with RP2350: Using RP2350 microcontrollers to build boards and products](https://pip.raspberrypi.com/documents/RP-008280-DS)
    
*   [Getting started with Raspberry Pi Pico-series microcontrollers: C/C++ development with Raspberry Pi Pico-series and other Raspberry Pi microcontroller-based boards](https://pip.raspberrypi.com/documents/RP-008276-DS)

Additionally, Raspberry Pi provides the following supporting hardware design resources:

*   [STEP file](https://pip.raspberrypi.com/documents/RP-008303-DS): a 3-dimensional CAD model of the board for enclosure and mechanical design.
    
*   [Fritzing](https://fritzing.org) part: component for use in Fritzing, an electronics design tool for layouts and schematics: [Fritzing part for Raspberry Pi Pico 2](https://pip.raspberrypi.com/documents/RP-008300-DS).

Important

Design files for Raspberry Pi Pico 2 and Pico 2 with headers are openly available with no limitations. Raspberry Pi grants permission to use, copy, modify, and distribute the following designs for any purpose, with or without fee. Designs are provided 'as-is' and the author disclaims all warranties with regard to the design, including all implied warranties of merchantability and fitness. In no event shall the author be liable for any special, direct, indirect, or consequential damages or any damages whatsoever resulting from loss of use, data, or profits, whether in an action of contract, negligence, or other tortious action, arising out of or in connection with the use or performance of the design.

### [](#wireless_pico2)Wireless Raspberry Pi Pico 2 boards

Raspberry Pi **Pico 2 W** and **Pico 2 W with headers** are wireless microcontroller boards based on the RP2350 chip. Both boards offer identical hardware capabilities, with the only physical differences being the presence of presoldered header pins on Raspberry Pi Pico 2 with headers, and the style of the debug connector below the microcontroller. For more information, see [Debug connector (SWD)](#swd).

The pinout and board layout for Raspberry Pi **Pico 2 W** and **Pico 2 W with headers** is the same as for Raspberry Pi **Pico W** and **Pico WH**. For more information, see [Wireless board layout](#layout_wireless).

#### [](#key-features-4)Key features

Raspberry Pi **Pico 2 W** and **Pico 2 W with headers** offer the same key features as Raspberry Pi **Pico 2** and **Pico 2 with headers**, but with added wireless functionality. Specifically, Raspberry Pi Pico 2 W and Pico 2 W with headers offer the following key features:

*   **RP2350 microcontroller chip**, including:
    
    *   A choice of CPU architectures that can run tasks in parallel. For more information, see [Architecture switching](../microcontrollers/microcontroller-chips.html#architecture_switching):
        
        *   Dual-core Arm Cortex-M33.
            
        *   Dual-core Hazard3 RISC-V processor.

    *   Flexible clock running up to 150 MHz.
        
    *   520 kB of SRAM.
        
    *   USB 1.1 controller and PHY with device and host support.
        
    *   Low-power sleep and dormant modes.
        
    *   Accurate clock and timer.
        
    *   Temperature sensor.
        
    *   Twelve Programmable I/O (PIO) state machines for custom peripheral support.
        
        *   Flexible, user-programmable high-speed I/O.
            
        *   Can emulate interfaces such as SD card and VGA.

*   **Board features**:
    
    *   Drag-and-drop programming using mass storage over USB.
        
    *   4 MB of on-board flash memory.
        
    *   26 multi-function GPIO pins. For more information, see [Non-wireless board layout](#layout_non-wireless).
        
    *   Hardware and software compatibility with Raspberry Pi Pico 1.
        
    *   Two timers with 4 alarms, and an AON timer.
        
    *   Debug connector. For more information, see [Debug connector (SWD)](#swd).

*   **Peripheral interfaces**:
    
    *   Two SPI
        
    *   Two I2C
        
    *   Two UART
        
    *   Three 12-bit ADC
        
    *   16 PWM channels

*   **Wireless connectivity**:
    
    *   Wi-Fi (802.11n):
        
        *   Single-band (2.4 GHz).
            
        *   WPA3, a modern security protocol for wireless connectivity.
            
        *   Soft access point for broadcasting a Wi-Fi network, supporting up to four clients.

    *   Bluetooth 5.2:
        
        *   Support for Bluetooth Low Energy (BLE) Central and Peripheral roles.
            
        *   Support for Bluetooth Classic.

For more information about the wireless hardware and functionality of Raspberry Pi Pico 2 W and Pico 2 W with headers, see [Wireless models](#wireless_models).

#### [](#resources-for-wireless-raspberry-pi-pico-2-boards)Resources for wireless Raspberry Pi Pico 2 boards

Raspberry Pi offers additional technical documentation relevant to Raspberry Pi Pico 2 W and Pico 2 W with headers:

*   [RP2350 Datasheet: A microcontroller by Raspberry Pi](https://pip.raspberrypi.com/documents/RP-008373-DS)
    
*   [Raspberry Pi Pico 2 W Datasheet: An RP2350-based microcontroller board](https://pip.raspberrypi.com/documents/RP-008304-DS)
    
*   [Hardware design with RP2350: Using RP2350 microcontrollers to build boards and products](https://pip.raspberrypi.com/documents/RP-008280-DS)
    
*   [Connecting to the Internet with Raspberry Pi Pico W-series: Getting online with C/C++ or MicroPython on W-series devices](https://pip.raspberrypi.com/documents/RP-008257-DS)

Additionally, Raspberry Pi provides a [schematic diagram](https://pip.raspberrypi.com/documents/RP-008306-DS) to support hardware design.

Important

Design files for Raspberry Pi Pico 2 W and Pico 2 W with headers are openly available with no limitations. Raspberry Pi grants permission to use, copy, modify, and distribute the following designs for any purpose, with or without fee. Designs are provided 'as-is' and the author disclaims all warranties with regard to the design, including all implied warranties of merchantability and fitness. In no event shall the author be liable for any special, direct, indirect, or consequential damages or any damages whatsoever resulting from loss of use, data, or profits, whether in an action of contract, negligence, or other tortious action, arising out of or in connection with the use or performance of the design.

[](#wireless_models)Wireless models
-----------------------------------

Wireless Raspberry Pi Pico models (Raspberry Pi **Pico W**, **Pico WH**, **Pico 2 W**, and **Pico 2 W with headers**) integrate Wi-Fi and Bluetooth connectivity directly into the board, making them suitable for connected and IoT applications, without requiring external radio modules.

### [](#wireless-hardware-and-antenna)Wireless hardware and antenna

Wireless Raspberry Pi Pico models use the **Infineon CYW43439** wireless chip, connected to the on-board microcontroller through an SPI interface operating at up to 33 MHz. Wireless Raspberry Pi Pico models also feature an on-board antenna licensed from **ABRACON** (formerly ProAnt).

Because this wireless subsystem shares some of the pins, some interface signals are multiplexed with other board functions.

*   The SPI clock line (`CLK`) is shared with the `VSYS` voltage monitor, and so the ADC can only read `VSYS` when no SPI transaction is in progress.
    
*   The Infineon CYW43439 `DIN/OUT` and `IRQ` signals share a pin, so you can only check for interrupt requests (IRQ) when no SPI transaction is in progress.

For optimal wireless performance, keep the antenna space free. Placing metal near or under the antenna can significantly reduce signal gain and bandwidth; grounded metal placed along the sides of the antenna can improve the antenna’s bandwidth.

### [](#wireless-software-licensing)Wireless software licensing

The software libraries, `libcyw43` and `BTstack`, are free to use for non-commercial projects. However, Raspberry Pi has negotiated special commercial rights for Raspberry Pi Pico and microcontroller users. This means that users are granted a free licence for commercial use for projects built with:

*   Wireless Raspberry Pi Pico boards (Raspberry Pi **Pico W**, **Pico WH**, **Pico 2 W**, and **Pico 2 W with headers**).
    
*   A combination of **RP2040** and **CYW43439**, or **RP2350** and **CYW43439**.

For the full `libcyw43` commercial licence, see [cyw43-driver in GitHub](https://github.com/georgerobotics/cyw43-driver/blob/main/LICENSE.RP). For the full `BTstack` commercial licence, see [pico\_btstack in GitHub](https://github.com/raspberrypi/pico-sdk/blob/master/src/rp2_common/pico_btstack/LICENSE.RP).

[](#layouts)Board layouts
-------------------------

Raspberry Pi Pico boards provide minimal external circuitry to support the microcontroller chip. This section describes the physical layout and pin assignments (pinouts) of Raspberry Pi Pico boards. Non-wireless Raspberry Pi Pico boards share a common layout and pinout, as do wireless Raspberry Pi Pico boards.

### [](#layout_non-wireless)Non-wireless board layout

[Figure 3](#non-wireless-pinout-pico) and [Figure 4](#non-wireless-pinout-pico2) provide a top-down view of non-wireless Raspberry Pi Pico and Pico 2 boards, including their pinouts. Aside from minor visual differences, the main layout is the same for all non-wireless boards: Raspberry **Pico**, **Pico H**, **Pico 2**, and **Pico 2 with headers**. The only major visual difference between these non-wireless boards is the presence or absence of presoldered headers, and the exact nature of the SWD interface; for more information, see [Debug connector (SWD)](#swd).

pico pinout

The pinout and board layout diagram of a non-wireless Raspberry Pi Pico board

pico 2 r4 pinout

The pinout and board layout diagram of a non-wireless Raspberry Pi Pico 2 board

Broadly, a non-wireless Raspberry Pi Pico board is laid out as follows:

*   The Micro USB port for power and data is located at the top edge of the board.
    
*   The LED (connected to `GP25`) is located to the left of the Micro USB port.
    
*   The **BOOTSEL** button is located under the USB port and to the left side of the board.
    
*   The microcontroller chip is located near the middle of the board.
    
*   The **DEBUG** pads (SWD interface) are located at the bottom edge of the board. For more information, see [Debug connector (SWD)](#swd).
    
*   40 pins are located on the left and right edges of the board, 20 on each side. For more information, see [Pin functions](#pin_functions).

### [](#layout_wireless)Wireless board layout

[Figure 5](#non-wireless-pinout-picow) and [Figure 6](#non-wireless-pinout-pico2w) provide a top-down view of wireless Raspberry Pi Pico and Pico 2 boards, including their pinouts. Aside from minor visual differences, the main layout is the same for all wireless boards: Raspberry **Pico W**, **Pico WH**, **Pico 2 W**, and **Pico 2 W with headers**. The only major visual difference between these wireless boards is the presence or absence of presoldered headers, and the exact nature of the SWD interface; for more information, see [Debug connector (SWD)](#swd).

picow pinout

The pinout and board layout diagram of a wireless Raspberry Pi Pico board

pico2w pinout

The pinout and board layout diagram of a wireless Raspberry Pi Pico 2 board

Broadly, a wireless Raspberry Pi Pico board is laid out as follows:

*   The Micro USB port for power and data is located at the top edge of the board.
    
*   The LED (connected to the wireless chip through `WL_GPIO0`) is located to the left of the Micro USB port.
    
*   The **BOOTSEL** button is located under the USB port and to the left side of the board.
    
*   The microcontroller chip is located near the middle of the board.
    
*   The **DEBUG** pads (SWD interface) are located below the microcontroller and to the right. For more information, see [Debug connector (SWD)](#swd).
    
*   40 pins are located on the left and right edges of the board, 20 on each side. For more information, see [Pin functions](#pin_functions).

### [](#pin_functions)Pin functions

The majority of the microcontroller pins are brought to the user I/O pins on the left and right edges of the board. Four microcontroller I/O pins are used for internal functions: driving an LED, on-board Switched Mode Power Supply (SMPS) power control, and sensing system voltages. Aside from the ground (`GND`) pins, the 40 pins on the left and right side of a non-wireless Pico board include:

*   26 GPIO pins with overlapping functions (SPI, I2C, UART, and so on) that can be configured for different project needs.
    
*   Power pins located in the top-right of the board, including:
    
    *   `3V3(OUT)` at pin 36 (3.3 V regulated output).
        
    *   `VSYS` at pin 39 (2 V to 5 V system input).
        
    *   `VBUS` at pin 40 (5 V input from USB).

*   Special-purpose pins:
    
    *   `3V3_EN` at pin 37. Pulling this pin to ground turns off the Raspberry Pi Pico.
        
    *   `ADC_VREF` at pin 35. Provides the reference voltage for ADC converters.
        
    *   `AGND` at pin 33 (also a `GND` pin). An analogue ground used to provide noise-free ground for sensors.
        
    *   `RUN` at pin 30. The microcontroller reset pin.

[](#swd)Debug connector (SWD)
-----------------------------

All Raspberry Pi Pico boards include a three-pin **Serial Wire Debug (SWD)** header, which is the connector for programming and debugging the built-in microcontroller on the board.

The three-pin connector always carries `SWDIO` (Serial Wire Debug data), `GND` (ground), and `SWCLK` (Serial Wire Debug clock). There’s no power pin on this connector. Your Raspberry Pi Pico board must be powered separately over USB or `VSYS`.

The connector’s location and type differs depending on the board variant, summarised in [Table 3](#debug). To compare the visual difference between the SWD headers, see [Figure 1](#pico1-image) in the introduction for [Raspberry Pi Pico](#pico1) and [Figure 2](#pico2-image) in the introduction for [Raspberry Pi Pico 2](#pico2).

Debug connector location and type based on the Raspberry Pi Pico board variant   

Location

Type

Raspberry Pi **Pico** and **Pico 2**

Bottom edge of the board

Three castellated through-hole pads

Raspberry Pi **Pico H** and **Pico 2 with headers**

Bottom edge of the board

Keyed three-pin connector (JST-style)

Raspberry Pi **Pico W** and **Pico 2 W**

Central, just below the microcontroller chip

Three through-hole pads

Raspberry Pi **Pico WH** and **Pico 2 W with headers**

Central, just below the microcontroller chip

Keyed three-pin connector (JST-style)

### [](#debug-connector-locations)Debug connector locations

The location of the debug connector depends on whether the board is a non-wireless or wireless variant:

*   On non-wireless variants (Raspberry Pi **Pico**, **Pico H**, **Pico 2**, and **Pico 2 with headers**), the connector is located at the bottom of the board. For a diagram that shows the location of the debug connector on non-wireless boards, see [Non-wireless board layout](#layout_non-wireless).
    
*   On wireless variants (Raspberry Pi **Pico W**, **Pico WH**, **Pico 2 W**, and **Pico 2 W with headers**), the connector is located underneath the microcontroller chip nearer the middle of the board. For a diagram that shows the location of the debug connector on wireless boards, see [Wireless board layout](#layout_wireless).

### [](#debug-connector-types)Debug connector types

The connector type depends on whether the board has presoldered headers:

*   Boards without presoldered headers (Raspberry Pi **Pico**, **Pico W**, **Pico 2** and **Pico 2 W**) use three castellated through-hole pads.
    
*   Boards with presoldered headers (Raspberry Pi **Pico H**, **Pico WH**, **Pico 2 with headers**, and **Pico 2 W with headers**) use a small, keyed three-pin connector (JST-style). For information about this connector, see [Raspberry Pi 3-pin Debug Connector Specification](https://pip.raspberrypi.com/documents/RP-008189-DS).

The debug connectors on Raspberry Pi Pico boards with headers fit the Raspberry Pi Debug Probe with no modification. For more information, see [Debug Probe](../microcontrollers/debug-probe.html).

[](#software-utilities)Software utilities
-----------------------------------------

This section describes software tools and utilities available for Raspberry Pi Pico-series devices, including tools for device inspection, debugging, and flash memory management.

### [](#identify-what-has-been-programmed)Identify what has been programmed

If you’re unsure about what’s currently programmed on your Raspberry Pi Pico, and the program was built using the Pico C or C++ SDK, the binary typically contains metadata such as the application name and version information.

Use the `picotool` command-line to extract and display this information. For more information, see our [picotool GitHub repository](https://github.com/raspberrypi/picotool). For full usage instructions, see [Getting started with Raspberry Pi Pico-series: C/C++ development with Raspberry Pi Pico-series and other Raspberry Pi microcontroller-based boards](https://pip.raspberrypi.com/documents/RP-008276-DS).

### [](#debug-using-a-pico-series-device)Debug using a Pico-series device

One Raspberry Pi Pico-series device can be used to debug another by running `debugprobe`, which enables a Raspberry Pi Pico to function as a USB-to-SWD and UART converter. To install the `debugprobe` firmware:

1.  Download the latest firmware release form the debugprobe GitHub repository:
    
    *   `debugprobe_on_pico.uf2` for the first generation of Raspberry Pi Pico.
        
    *   `debugprobe_on_pico2.uf2` for Raspberry Pi Pico 2.

2.  On the Raspberry Pi Pico that you intend to use as a debugger, hold down the **BOOTSEL** button at the same time as you connect it to your computer. A USB mass storage device named RPI-RP2 (Pico) or RP2350 (Pico 2) appears and is mounted as a volume.
    
3.  Copy the appropriate UF2 file to the mounted volume. The volume automatically ejects after the transfer completes.
    
4.  Wait for the device to reboot. Your device now runs the `debugprobe` firmware and you can start using it as a debugger.

For more detailed instructions, see [Getting started with Raspberry Pi Pico-series: C/C++ development with Raspberry Pi Pico-series and other Raspberry Pi microcontroller-based boards](https://pip.raspberrypi.com/documents/RP-008276-DS).

### [](#reset-flash-memory)Reset flash memory

`BOOTSEL` mode resides in read-only memory, inside the microcontroller chip on the Raspberry Pi Pico board; it can’t be re-written. As a result, holding the **BOOTSEL** button while connecting the board always presents the device as a USB mass storage device, ensuring that the board can’t be permanently bricked through software.

If you want to erase the external flash memory, you can copy a special [UF2 file](https://pip.raspberrypi.com/documents/RP-008273-DS) to the Raspberry Pi Pico device while it’s in `BOOTSEL` mode. For the code to erase the external flash memory, see our [pico-examples GitHub repository](https://github.com/raspberrypi/pico-examples/blob/master/flash/nuke/nuke.c).

### [](#resources-for-software-development)Resources for software development

Raspberry Pi offers additional technical documentation development with Raspberry Pi Pico:

*   [Raspberry Pi Pico C/C++ SDK: Libraries and tools for C/C++ development on Raspberry Pi microcontrollers](https://pip.raspberrypi.com/documents/RP-009085-KB)
    
*   [Raspberry Pi Pico-series Python SDK: A MicroPython environment for Raspberry Pi microcontrollers](https://pip.raspberrypi.com/documents/RP-008355-DS)

For API-level Doxygen documentation for the Raspberry Pi Pico C/C++ SDK, see [Pico C SDK](../pico-sdk/index.html).

#### On this page

You can view and edit the Raspberry Pi documentation source [on Github](https://github.com/raspberrypi/documentation/). Please read our [usage and contributions policy](https://github.com/raspberrypi/documentation/blob/master/CONTRIBUTING.md) before you make a Pull Request.

Raspberry Pi documentation is copyright © 2012-2026 Raspberry Pi Ltd and is licensed under a [Creative Commons Attribution-ShareAlike 4.0 International](https://creativecommons.org/licenses/by-sa/4.0/) (CC BY-SA) licence.

Some content originates from the [eLinux wiki](http://elinux.org/), and is licensed under a [Creative Commons Attribution-ShareAlike 3.0 Unported](http://creativecommons.org/licenses/by-sa/3.0/) licence.

The terms HDMI, HDMI High-Definition Multimedia Interface, HDMI trade dress and the HDMI Logos are trademarks or registered trademarks of HDMI Licensing Administrator, Inc

@import url("https://fonts.googleapis.com/css2?family=Roboto:wght@400;700&display=swap"); #\_\_rptl-footer .\_\_rptl-footer-link, #\_\_rptl-footer .\_\_rptl-footer-link--with-icon, #\_\_rptl-footer .\_\_rptl-footer-item, #\_\_rptl-footer .\_\_rptl-footer-list, #\_\_rptl-footer .\_\_rptl-footer-heading, #\_\_rptl-footer .\_\_rptl-footer-column, #\_\_rptl-footer .\_\_rptl-footer-row, #\_\_rptl-footer .\_\_rptl-footer-container, #\_\_rptl-footer { box-sizing: border-box; margin: 0; padding: 0; border: 0; font: inherit; font-size: 100%; vertical-align: baseline; } #\_\_rptl-footer { display: block; font-family: "Roboto", sans-serif; font-size: medium; font-weight: 400; line-height: 1.5; text-rendering: optimizeLegibility; -webkit-text-size-adjust: 100%; -moz-text-size-adjust: 100%; text-size-adjust: 100%; letter-spacing: normal; -webkit-font-smoothing: antialiased; -moz-osx-font-smoothing: grayscale; background: var(--rptl-footer-background-color, #f5f6f9); overflow: hidden; } #\_\_rptl-footer .\_\_rptl-footer-container { width: 100%; max-width: 1300px; padding-left: 16px; padding-right: 16px; margin: auto; margin-top: 32px; } @media (min-width: 800px) { #\_\_rptl-footer .\_\_rptl-footer-container { padding: 0 76px; } } @media (min-width: 1200px) { #\_\_rptl-footer .\_\_rptl-footer-container { padding: 0 84px; } } #\_\_rptl-footer .\_\_rptl-footer-row { display: flex; flex-wrap: wrap; } #\_\_rptl-footer .\_\_rptl-footer-column { flex-basis: 1; width: 100%; padding-right: 8px; } @media (min-width: 640px) { #\_\_rptl-footer .\_\_rptl-footer-column { width: 50%; } } @media (min-width: 1024px) { #\_\_rptl-footer .\_\_rptl-footer-column { width: 25%; } } #\_\_rptl-footer .\_\_rptl-footer-heading { font-weight: 700; color: var(--rptl-footer-text-color, #333); margin-bottom: 8px; } #\_\_rptl-footer .\_\_rptl-footer-list { list-style: none; margin-bottom: 32px; } #\_\_rptl-footer .\_\_rptl-footer-item { margin-bottom: 8px; } #\_\_rptl-footer .\_\_rptl-footer-icon { margin-right: 0.5em; fill: var(--rptl-footer-text-color, #333); } #\_\_rptl-footer .\_\_rptl-footer-link, #\_\_rptl-footer .\_\_rptl-footer-link--with-icon { font-weight: 400; color: var(--rptl-footer-text-color, #333); text-decoration: none; } #\_\_rptl-footer .\_\_rptl-footer-link--with-icon { display: inline-flex; align-items: center; } #\_\_rptl-footer .\_\_rptl-footer-link:hover, #\_\_rptl-footer .\_\_rptl-footer-link--with-icon:hover { text-decoration: underline; }

Follow us

*   [Sign up to newsletter](https://www.raspberrypi.com/weekly/)
*   [X](https://x.com/Raspberry_Pi)
*   [Threads](https://www.threads.net/@raspberrypi)
*   [TikTok](https://www.tiktok.com/@raspberry_pi)
*   [YouTube](https://youtube.com/raspberrypi)
*   [Instagram](https://www.instagram.com/raspberrypi/)
*   [LinkedIn](https://www.linkedin.com/company/raspberrypi/)
*   [Facebook](https://www.facebook.com/raspberrypi)

About Raspberry Pi

*   [News](https://www.raspberrypi.com/news/)
*   [Investor relations](https://investors.raspberrypi.com/)
*   [Contact us](https://www.raspberrypi.com/contact/)
*   [Trademark](https://www.raspberrypi.com/trademark-rules/)
*   [About us](https://www.raspberrypi.com/about/)
*   [Our Approved Resellers](https://www.raspberrypi.com/resellers/)
*   [Jobs](https://www.raspberrypi.com/jobs/)
*   [Accessibility](https://www.raspberrypi.com/accessibility/)
*   [Sustainability](https://www.raspberrypi.com/sustainability/)
*   [Modern slavery statement](https://www.raspberrypi.com/modern-slavery-statement/)
*   [Site use terms and conditions](https://www.raspberrypi.com/terms-and-conditions/)
*   [Acceptable use](https://www.raspberrypi.com/acceptable-use/)
*   [Cookies](https://www.raspberrypi.com/cookies/)
*   [Licensing](https://www.raspberrypi.com/licensing/)
*   [Terms and conditions of sale](https://www.raspberrypi.com/terms-conditions-sale/)
*   [Privacy](https://www.raspberrypi.com/privacy/)
*   [Security](https://www.raspberrypi.com/contact/security/)
*   [Verify our bank details](https://www.raspberrypi.com/verify/)

For home

*   [Raspberry Pi for home](https://www.raspberrypi.com/for-home/)
*   [Tutorials](https://www.raspberrypi.com/tutorials/)

For industry

*   [Raspberry Pi for industry](https://www.raspberrypi.com/for-industry/)
*   [Product compliance](https://www.raspberrypi.com/for-industry/compliance/)
*   [Industry updates](https://www.raspberrypi.com/for-industry/newsletter/)
*   [Thin clients](https://www.raspberrypi.com/for-industry/thin-clients/)
*   [Raspberry Pi in space](https://www.raspberrypi.com/for-industry/space/)
*   [Powered by Raspberry Pi](https://www.raspberrypi.com/for-industry/powered-by/)
*   [Design partners](https://www.raspberrypi.com/for-industry/design-partners/)
*   [Success stories](https://www.raspberrypi.com/success-stories/)

Hardware

*   [Computers and microcontrollers](https://www.raspberrypi.com/products/#raspberry-pi-computers-and-microcontrollers)
*   [Cameras and displays](https://www.raspberrypi.com/products/#cameras-and-displays)
*   [Add-on boards](https://www.raspberrypi.com/products/#add-on-boards)
*   [Power supplies and cables](https://www.raspberrypi.com/products/#power-supplies-and-cables)
*   [Cases](https://www.raspberrypi.com/products/#cases)
*   [Peripherals](https://www.raspberrypi.com/products/#peripherals)

Software

*   [Raspberry Pi Connect](https://www.raspberrypi.com/software/connect/)
*   [Raspberry Pi Desktop](https://www.raspberrypi.com/software/raspberry-pi-desktop/)
*   [Raspberry Pi Imager](https://www.raspberrypi.com/software/)
*   [Raspberry Pi OS](https://www.raspberrypi.com/software/operating-systems/)

Documentation

*   [All categories](https://www.raspberrypi.com/documentation/)
*   [Product information portal](https://pip.raspberrypi.com)
*   [Software sources](https://www.raspberrypi.com/documentation/computers/software-sources.html)

Community

*   [Forums](https://forums.raspberrypi.com/)
*   [Events](https://events.raspberrypi.com/)

Raspberry Pi Store

*   [Store information](https://www.raspberrypi.com/raspberry-pi-store/)

Raspberry Pi Press

*   [About Raspberry Pi Press](https://www.raspberrypi.com/books-magazines/)
*   [Raspberry Pi Official Magazine](https://magazine.raspberrypi.com)
*   [Books](https://magazine.raspberrypi.com/books)
*   [Write for us](https://magazine.raspberrypi.com/write-for-us)
*   [Contact Raspberry Pi Press](https://magazine.raspberrypi.com/contact)
