opsec-bot/Reactivity/(commit log)

2026-06-06 Phase 1 scaffold: project structure + dumper firmware
    - Directory layout (firmware/, rust-client/, scripts/, captures/, docs/)
    - ESP32-S3 host-mode dongle dumper firmware (HANDOFF §7)
    - scripts/capture_serial.py (pyserial capture helper)
    - README, PROGRESS, docs/notes lab notebook with COM-port map
    - .gitignore (Rust target, Arduino build, capture logs)
2026-06-06 Phase 1 complete: dongle decoded (Logitech 046D:C547)
    - Firmware: tag reports with source endpoint; document USBMode=default + the
    cdc_on_boot trap; build with DebugLevel=info to emit HID descriptors.
    - scripts/decode_reports.py: parse [EP xx RAW N] captures, decode the 13-byte
    mouse report (16-bit dx/dy, button bitfield, wheel/hwheel).
    - Findings recorded in PROGRESS.md / docs/notes.md: 3 HID interfaces, mouse on
    EP 0x81, full byte layout, all 5 buttons + wheel verified empirically.
2026-06-06 Forward Lightspeed mouse to Pico via UART
    Phase 2 change: replace the ESP32 raw-descriptor dumper with a mouse-forwarder that parses the Logitech Lightspeed dongle (EP 0x81) and sends compact framed HID events over UART1 to a Pico. ESP32: added UART1 link (1Mbaud), framing (0xAA55, len=7, type=0x01) and CRC8, extracts buttons/dX/dY/wheel/hwheel from the 13B report, blinks traffic LED and prints a 1s heartbeat count. Pico: new firmware that implements a TinyUSB HID mouse (5-button, 16-bit X/Y, wheel/pan), a small UART frame parser/CRC checker and state machine, and replays validated frames as USB HID reports to the PC; also exposes a CDC debug console and periodic stats. This enables low-late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
    [esp32_host.ino, pico_device.ino]
2026-06-06 Move docs into docs/ directory
    Move two hardware documentation files into the docs/ directory for better project organization: ESP32-S3-USB-OTG-DOCS.md and Pi-Pico-H-DOCS.md. These are pure renames (content unchanged).
2026-06-07 Phase 2: end-to-end pass-through working on DevKitC-1 host
    Moving the Superlight now moves the PC cursor through the full chain
    (dongle -> DevKitC USB host -> UART 1Mbaud -> Pico HID -> PC), verified
    on hardware with bad=0 frame integrity.
    Host board pivot OTG -> DevKitC-1: the OTG board did Phase 1 decode, but
    its free pins (GPIO47/48) are bare solder pads, so the UART link to the
    Pico needed a board with real headers. Dongle now reaches the DevKitC
    native USB host (GPIO19/20) via a USB-A female breakout.
    - Rewrite esp32_host.ino for the DevKitC: drop OTG board power-GPIO block,
    host on native USB, UART forwarder on GPIO47. Verified FQBN with
    FlashMode=opi (WROOM-2 Octal flash) + CDCO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
2026-06-07 Phase 3a: Tauri control app + Pico CDC JSON protocol
    Adds the PC-side control panel and teaches the Pico to speak the §9
    JSON-line command protocol over its USB-CDC port. move/click/scroll/
    watch/status verified end-to-end; remap is wired but deferred to 3b
    (needs the reverse-UART channel + ESP32 handler).
    rust-client/ — Tauri v2 desktop app
    - Frontend: Vite + React 19 + TS + Tailwind v4 + shadcn/ui (slate, dark).
    Connection, live status tiles, move/click/scroll controls, live event
    Watch table, remap form, raw console.
    - Backend: blocking `serialport` on a dedicated std::thread (NO async/
    tokio in our code, §11.6). Port-owning thread bridges CDC lines to
    Tauri events (serial://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
    [pico_device.ino]
2026-06-07 Phase 3b: DTR fix, button remap intercept, status LED
    DTR fix (the watch/status "not working" bug)
    - Adafruit TinyUSB CDC gates device->host writes on DTR
    (tud_cdc_connected()); serialport-rs left DTR low on open, so the Pico
    silently dropped every status/evt/ack line (PC->Pico still worked,
    which is why Control was fine). serial.rs now asserts DTR (+RTS) right
    after open. Status tiles, Watch and the Console <- stream now work.
    Button remap (ESP32 intercept)
    - App -> Pico (CDC) -> Pico forwards a §9 type=0x02 JSON frame on its
    reverse UART (GP0) -> ESP32 stores the rule and rewrites the buttons
    bitfield at the source in onReceive (applyRemap). Identity by default.
    - Scope: butt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
    [esp32_host.ino]
2026-06-07 Phase 4: Pico presents as a generic Logitech USB Receiver (046D:C547)
    The Pico now enumerates as "Logitech USB Receiver" (046D:C547) instead of
    the TinyUSB default 239A:CAFE — the same identity the real Superlight
    dongle would show to the PC. Generic Logitech ID per §11.3 (no
    cheat-device VID/PIDs).
    - pico_device.ino setup(): TinyUSBDevice.setManufacturerDescriptor /
    setProductDescriptor / setID(0x046D, 0xC547), then detach()/attach() to
    force re-enumeration (arduino-pico inits USB before setup() runs).
    Verified via `board list`: CDC enumerates as 046D:C547.
    - HID report descriptor unchanged -> passthrough/remap unaffected.
    - serial.rs: is_pico now matches both the old (239A:CAFE)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
2026-06-07 Add tauri dev and device log files
    Add two log files: out-tauri-dev.log (Tauri/Vite dev server and cargo build output, including HMR updates and a transient compile error about missing PICO_VID/PICO_PID and subsequent rebuilds) and out.log (device boot output and esp32 mouse forwarder telemetry). These are captured runtime logs for debugging the dev workflow and connected device behavior.
2026-09-24 Phase 5: 1 kHz ESP32 host polling and a no-drop Pico report queue
    ESP32: EspUsbHost::task() in loop() blocked ~1 tick twice per pass and
    re-armed the IN transfer on a millis() timer, so the dongle was polled at a
    few hundred Hz. Service the USB host from dedicated tasks instead, re-arm in
    the transfer callback, and keep 3 URBs queued on EP 0x81 (one URB capped the
    feed at ~500/s; three measured 941-997/s with the Superlight at 1 kHz). Arm
    only the mouse endpoint, give Serial1 a TX ring buffer, keep loop() cold-path.
    Pico: reports were dropped whenever the IN endpoint was busy. Route every
    report through a small coalescing queue (fold same-button reports, keep
    press/release edges ordered, ch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
2026-09-24 Add scripts/flash.py: detect, build and flash the plugged-in boards
    Detects the ESP32 (CP210x UART port) and the Pico (running firmware, other
    RP2040 firmware, or BOOTSEL) via `arduino-cli board list`, builds the matching
    sketch and flashes it. A Pico already running this firmware is rebooted into
    its bootloader by the 1200-baud touch and checked to re-enumerate as
    046D:C547. Missing boards are skipped; ambiguous ones need --esp-port /
    --pico-port. --json emits events for the Control app. Failures print a
    targeted hint. 15 offline tests in scripts/test_flash.py. Ignore __pycache__.
    [flash.py, test_flash.py]
2026-09-24 Control app: Firmware tab to build and flash from the GUI
    New Firmware tab: detects the boards, flashes all or one, shows per-step
    build/flash/verify progress with live output and actionable failure hints.
    Backend flash.rs runs scripts/flash.py --json on a std thread and forwards each
    line as a flash://event (one run at a time; `exit` is always last). Add
    serial::disconnect_blocking, which joins the reader thread so the COM port is
    really closed before flashing (disconnect only queued a message). The
    frontend closes the serial link first and reconnects afterwards.
2026-09-24 docs: record Phase 5, the flash tool and the Firmware tab
    Measured results (941-997 frames/s vs ~500 with one URB), what is and is not
    verified, README flashing section, and a correction to the "sub-2 ms by
    construction" latency claim in notes.md.
2026-09-24 On-board Lua scripts: G Hub-style API running on the Pico's core 1
    - Vendor Lua 5.4.8 (trimmed, 32-bit numbers, C recursion capped) into the
    Pico sketch; script_engine.cpp runs the VM on core 1 with its own 24 KB
    stack and a 96 KB heap cap, talking to core 0 through pico-sdk queues.
    - G Hub-compatible functions (OnEvent, MoveMouseRelative, PressMouseButton,
    IsMouseButtonPressed, Sleep, OutputLogMessage, ...) plus
    SetMouseButtonBlocked. Stop is immediate, held buttons are released.
    - Scripts can be saved to a 64 KB LittleFS partition and autostart at boot
    (FQBN now flash=2097152_65536).
    - CDC protocol: script_begin/chunk/end/run/stop/save/erase/status.
    - Control app: Scripts tab wit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
2026-09-24 Beginner setup guide + automatic versioned releases
    README: new "Setup (no coding needed)" section with a shopping list, a
    7-wire diagram (docs/wiring.svg), drag-and-drop / in-browser flashing
    and app install. The old Hardware/Getting started sections become
    "Build from source".
    .github/workflows/release.yml: on a vX.Y.Z tag (or a one-click
    patch/minor/major bump from the Actions tab) build the Windows
    installer + portable exe and both firmware images (Pico .uf2, ESP32
    merged .bin) and publish them as a GitHub Release. The version comes
    from the tag and is stamped into the app at build time.
2026-09-24 esp32_host: recover the mouse endpoint after a transfer error
    A failed interrupt transfer (e.g. while the mouse is switched off/on)
    halts the pipe in ESP-IDF, and every re-submit then fails until the
    endpoint is cleared. The bridge sat on "dongle present, no reports"
    (steady dim green LED) until it was power-cycled.
    Now an error flags the endpoint; the client task runs halt -> flush ->
    clear and re-arms. If it still refuses transfers after 1.5 s, the
    board restarts and re-enumerates the dongle. Recoveries are logged.
    [esp32_host.ino]
2026-09-24 Vendor the modified EspUsbHost so CI can build the ESP32 firmware
    The sketch relies on a locally patched EspUsbHost 1.0.1 (isReady,
    usbTransferSize, usbTransfer[] pointers); the stock library-manager
    version doesn't compile with it, which failed the v0.2.0 release job.
    It now lives in firmware/esp32_host/src/EspUsbHost and is included by
    path.
    [EspUsbHost.cpp, EspUsbHost.h, esp32_host.ino]
